Dfinitski/Odyssey_3_2015/BPF_ODY3/1_8_BPF.png

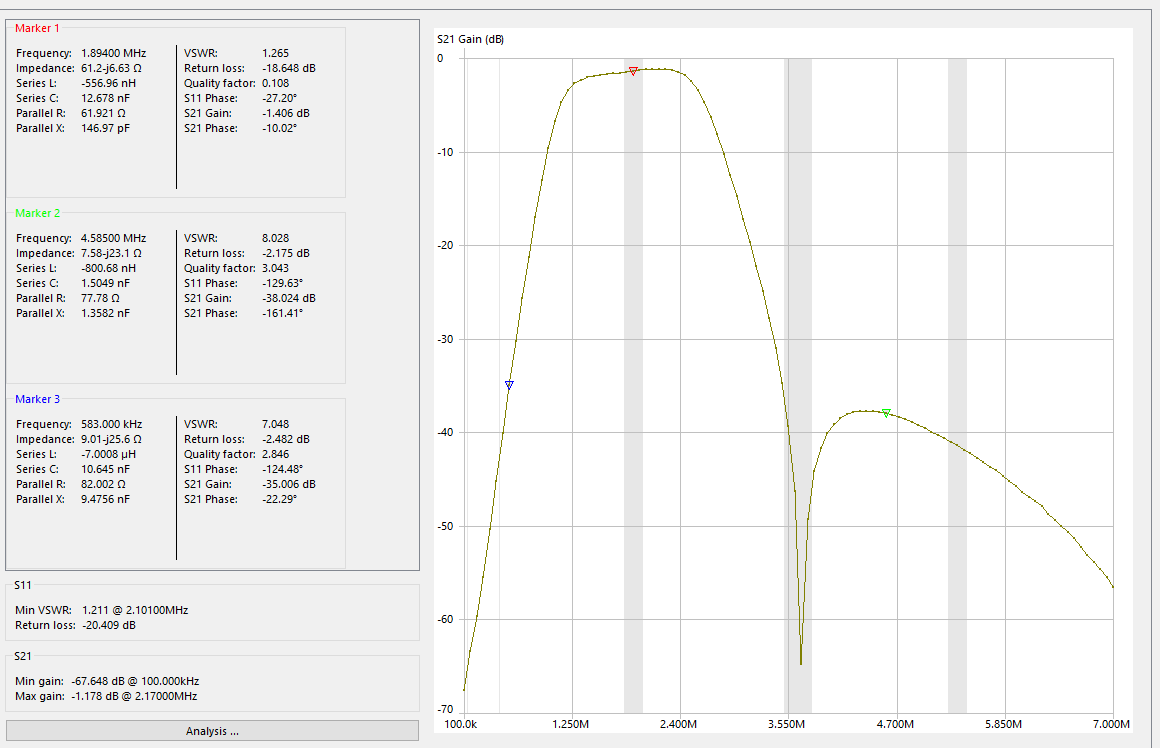
BPF_ODY3/1_8_BPF.png
