Dfinitski/Odyssey_3_2015/BPF_ODY3/3_5_BPF.png

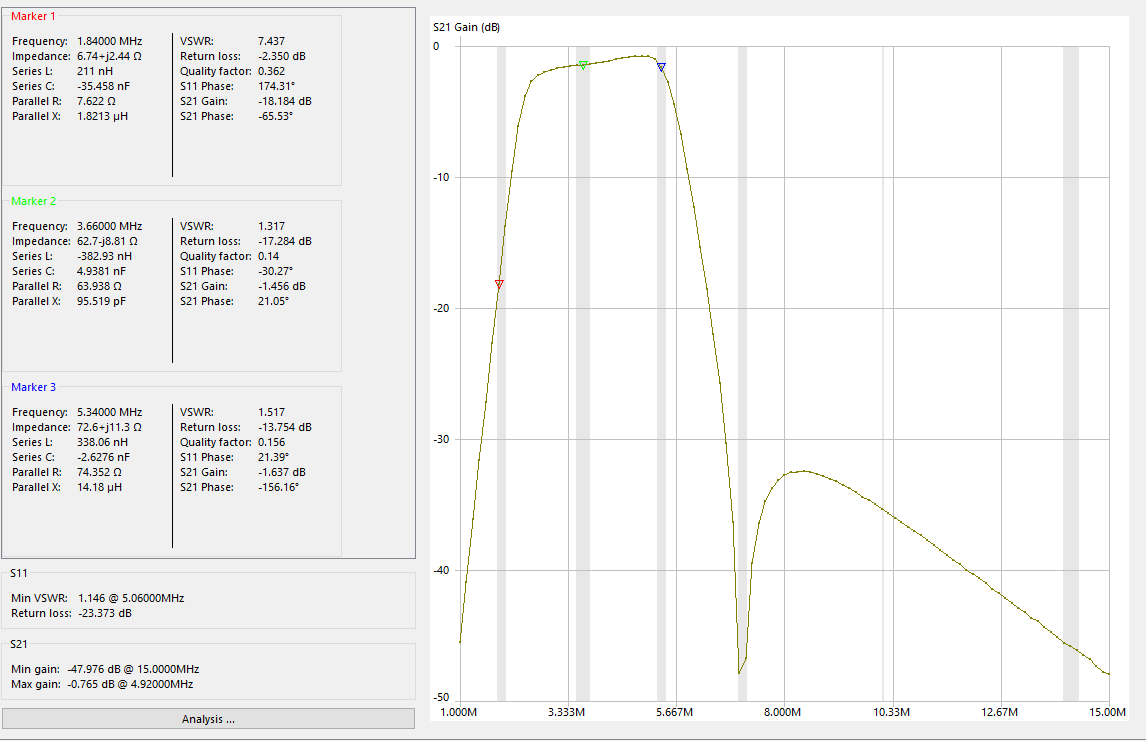
BPF_ODY3/3_5_BPF.png
