Dfinitski/Odyssey_3_2015/BPF_ODY3/7_0_BPF.png

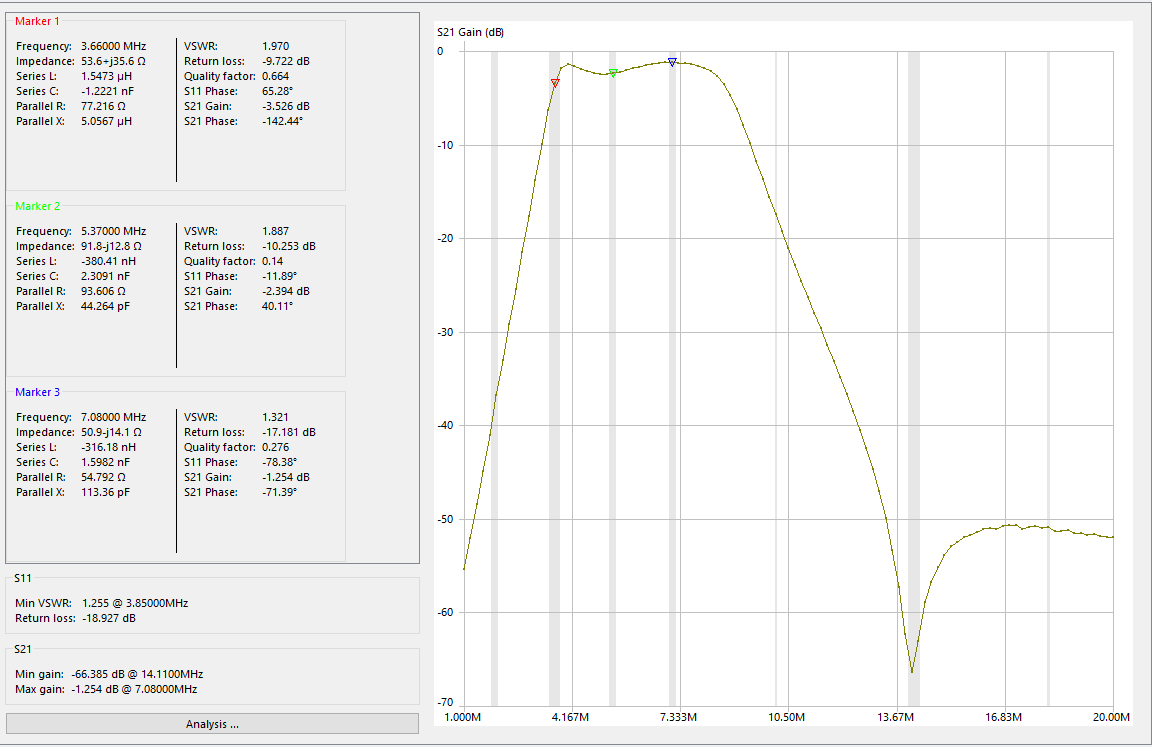
BPF_ODY3/7_0_BPF.png
