Dfinitski/Odyssey_3_2015/BPF_ODY3/14_BPF.png

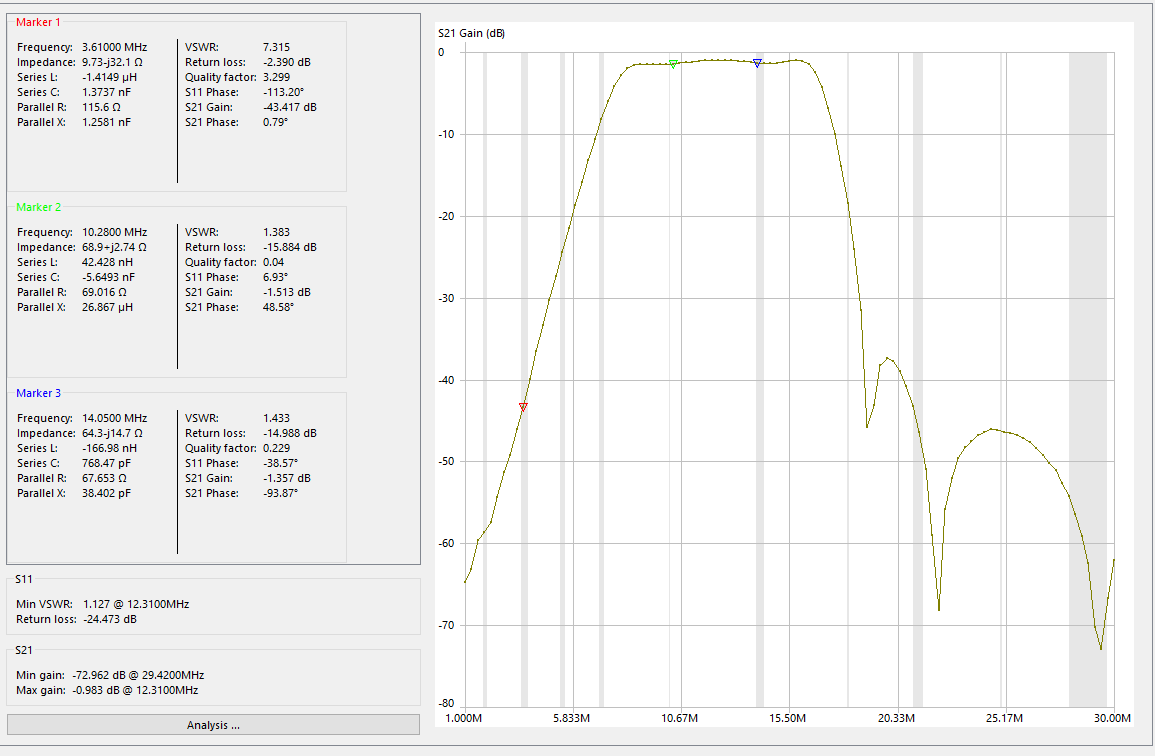
BPF_ODY3/14_BPF.png
