Dfinitski/Odyssey_3_2015/BPF_ODY3/30_BPF.jpg

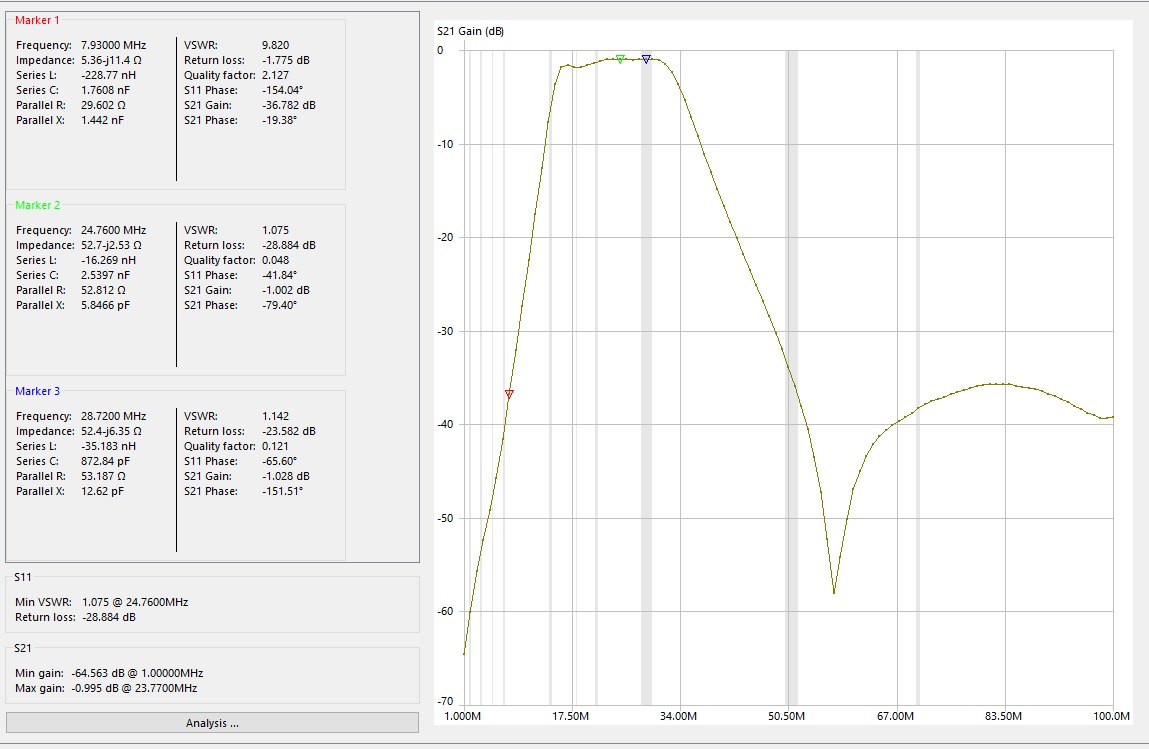
BPF_ODY3/30_BPF.jpg
