Dfinitski/Odyssey_3_2015/BPF_ODY3/50_BPF.png

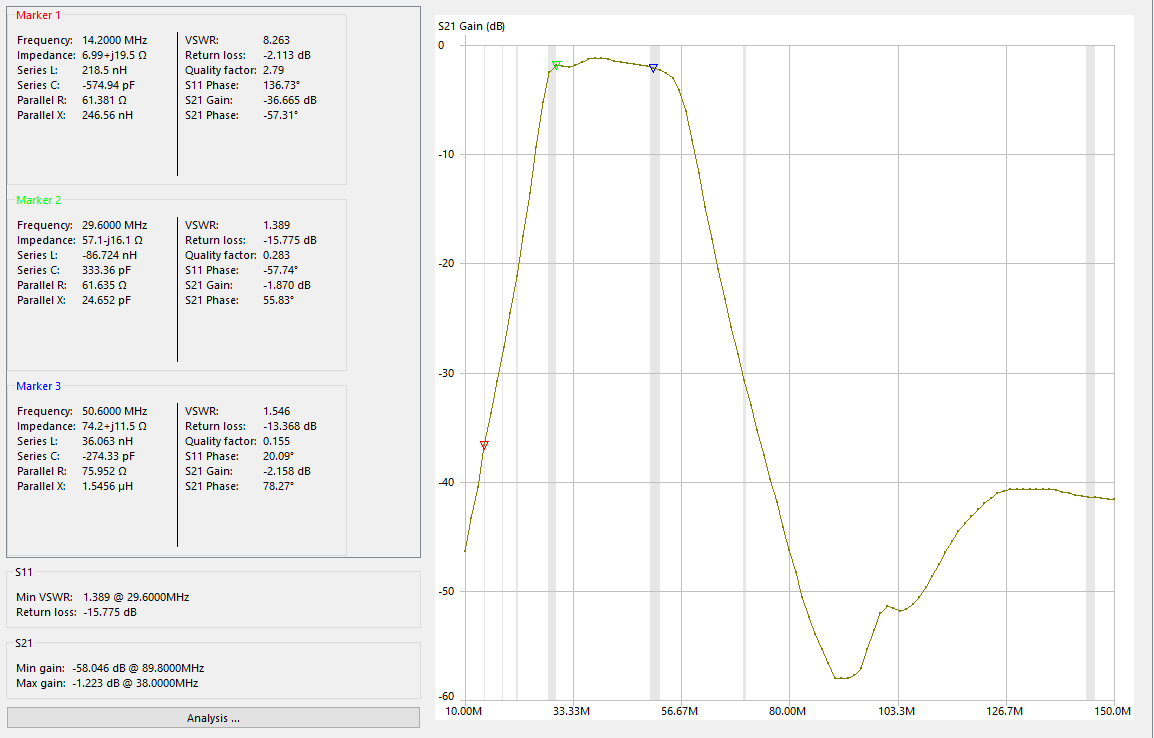
BPF_ODY3/50_BPF.png
