Dfinitski/Odyssey_3_2015/Images/odyssey_on_desk.jpg

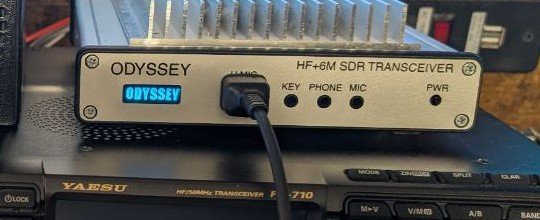
Images/odyssey_on_desk.jpg
