Dfinitski/Odyssey_3_2015/Images/rear_angle.jpg

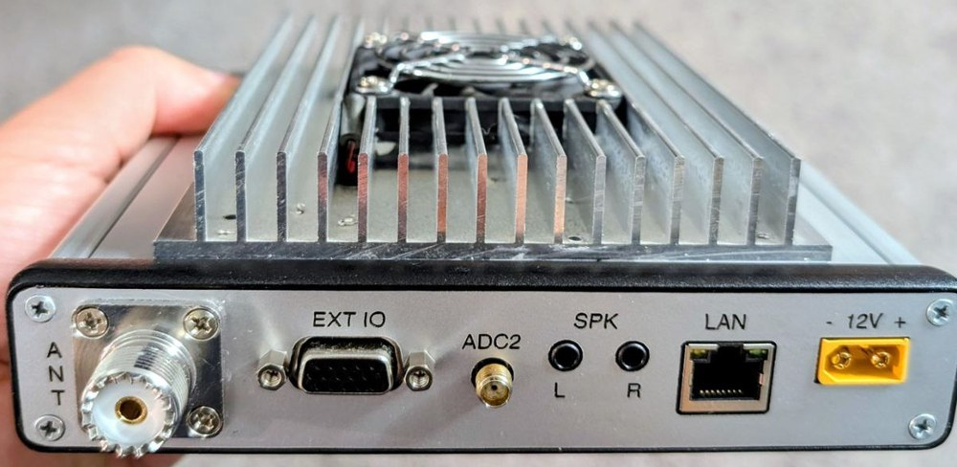
Images/rear_angle.jpg
