Dfinitski/Odyssey_3_2015/Images/station_2.jpg

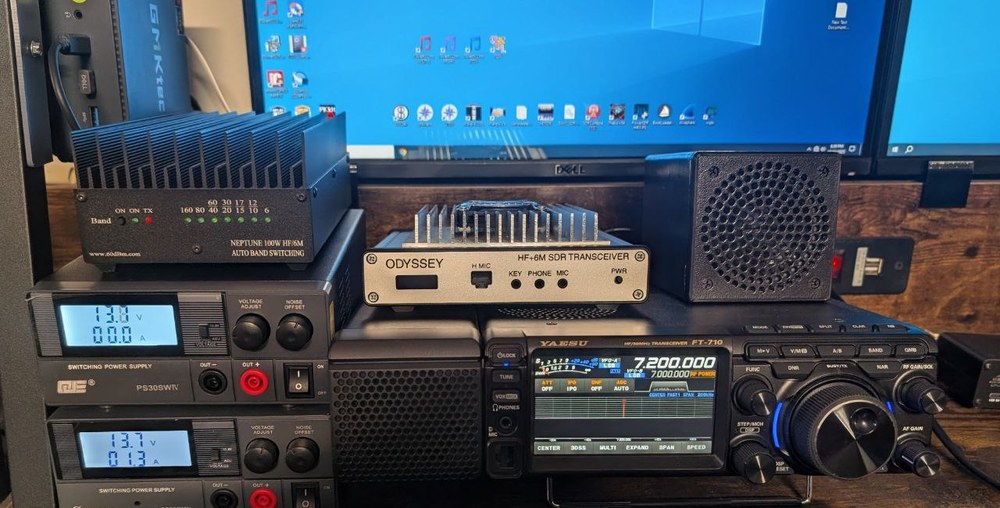
Images/station_2.jpg
