Dfinitski/Odyssey_3_2015/LPF_ODY_3/1_8_LPF.png

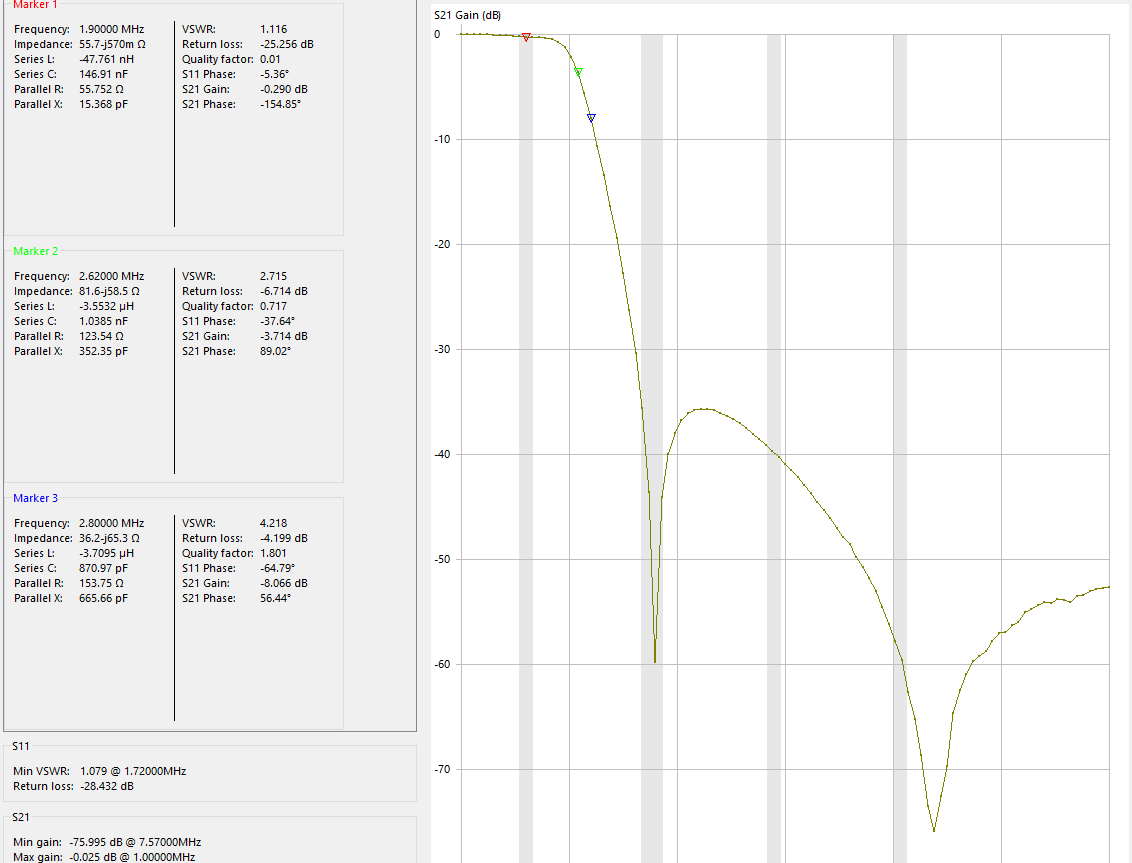
LPF_ODY_3/1_8_LPF.png
