Dfinitski/Odyssey_3_2015/LPF_ODY_3/50_LPF.png

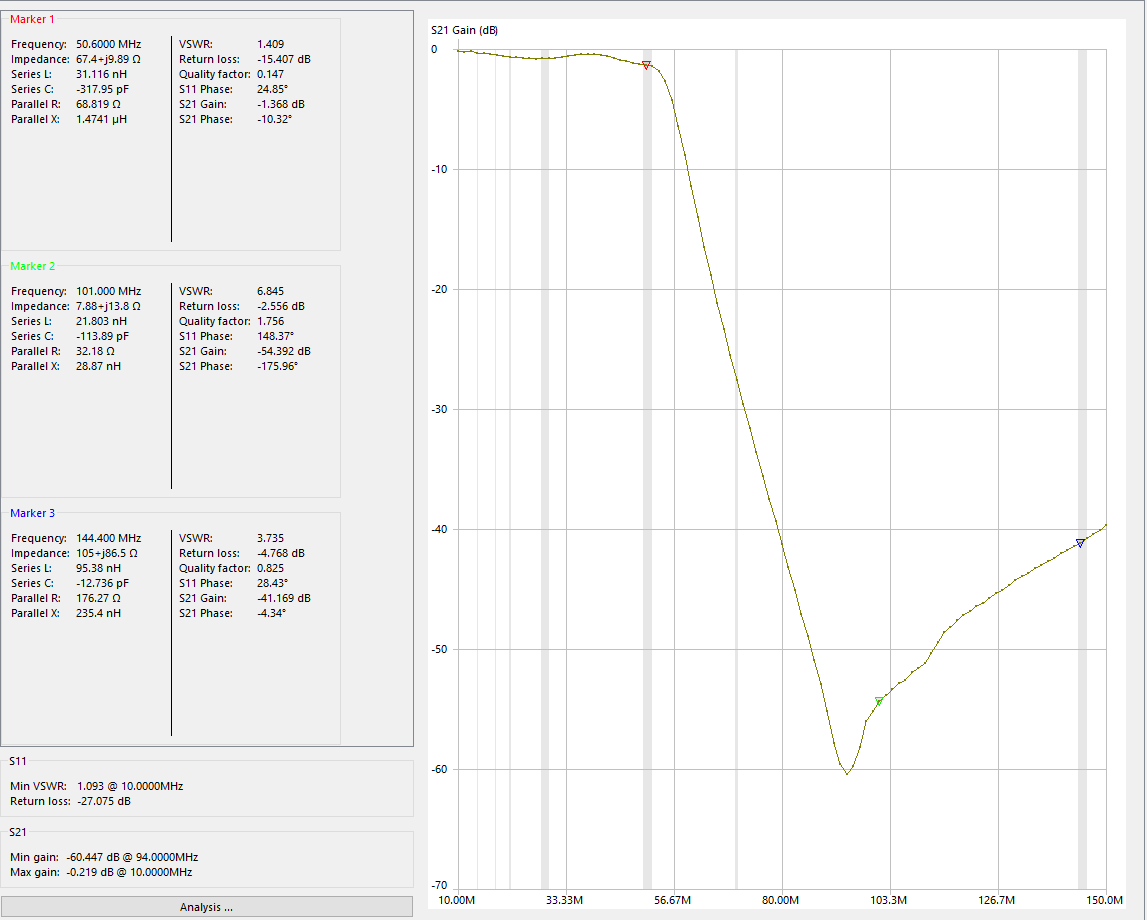
LPF_ODY_3/50_LPF.png
