Dfinitski/Odyssey_3_2015/Metalwork/Copper_Plate.jpg

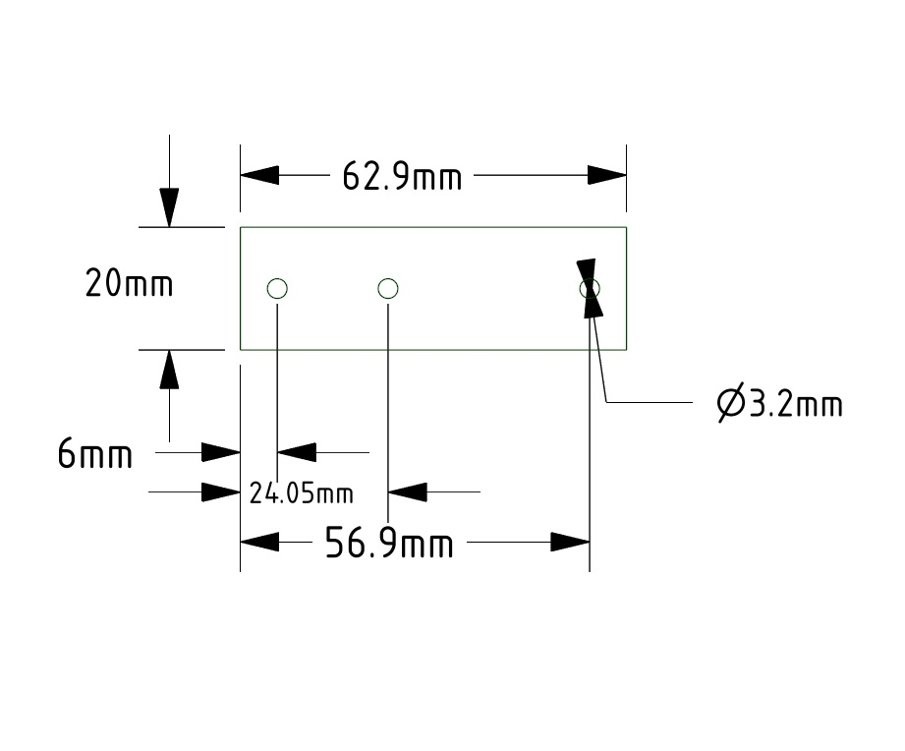
Metalwork/Copper_Plate.jpg
