Dfinitski/Odyssey_3_2015/Metalwork/Heatsink.jpg

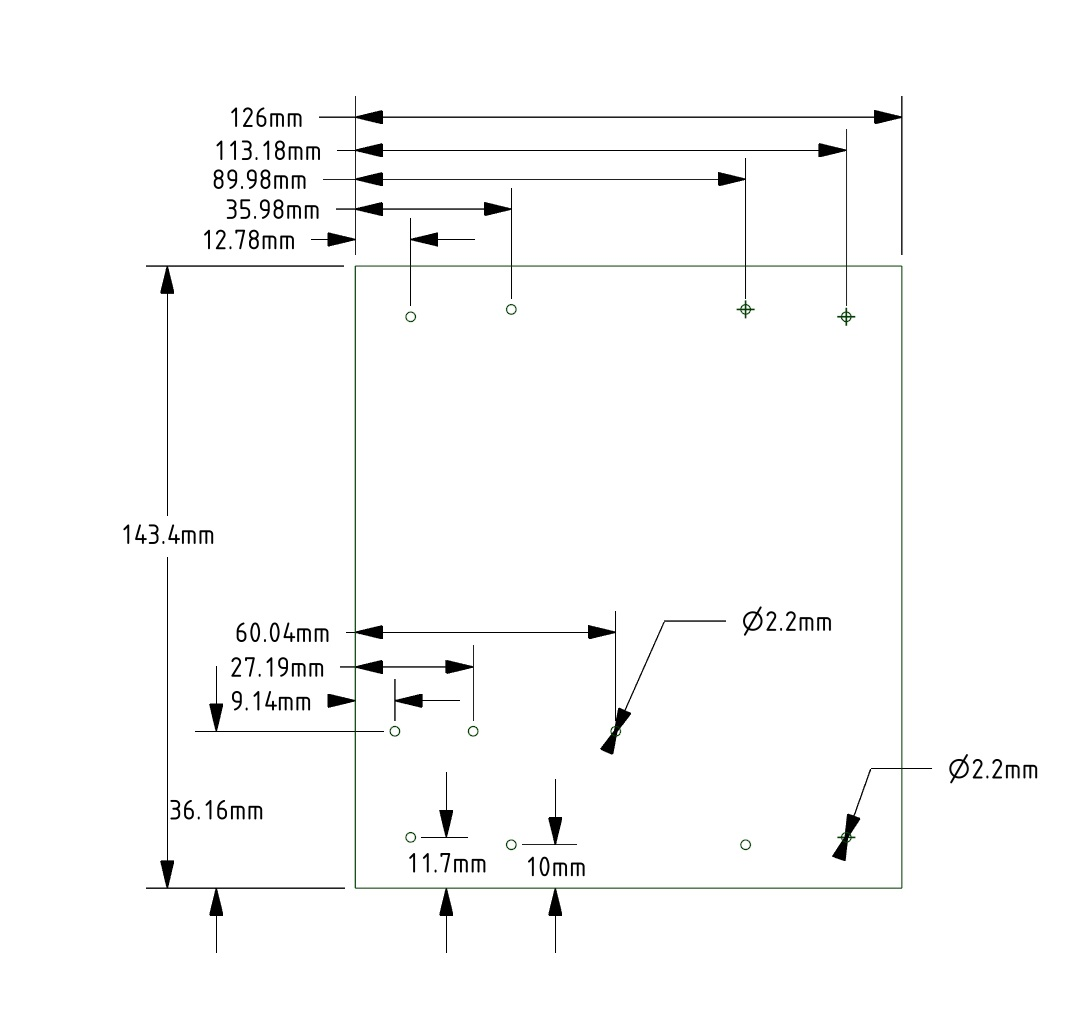
Metalwork/Heatsink.jpg
