Dfinitski/Odyssey_3_2015/Metalwork/Top_Cover.jpg

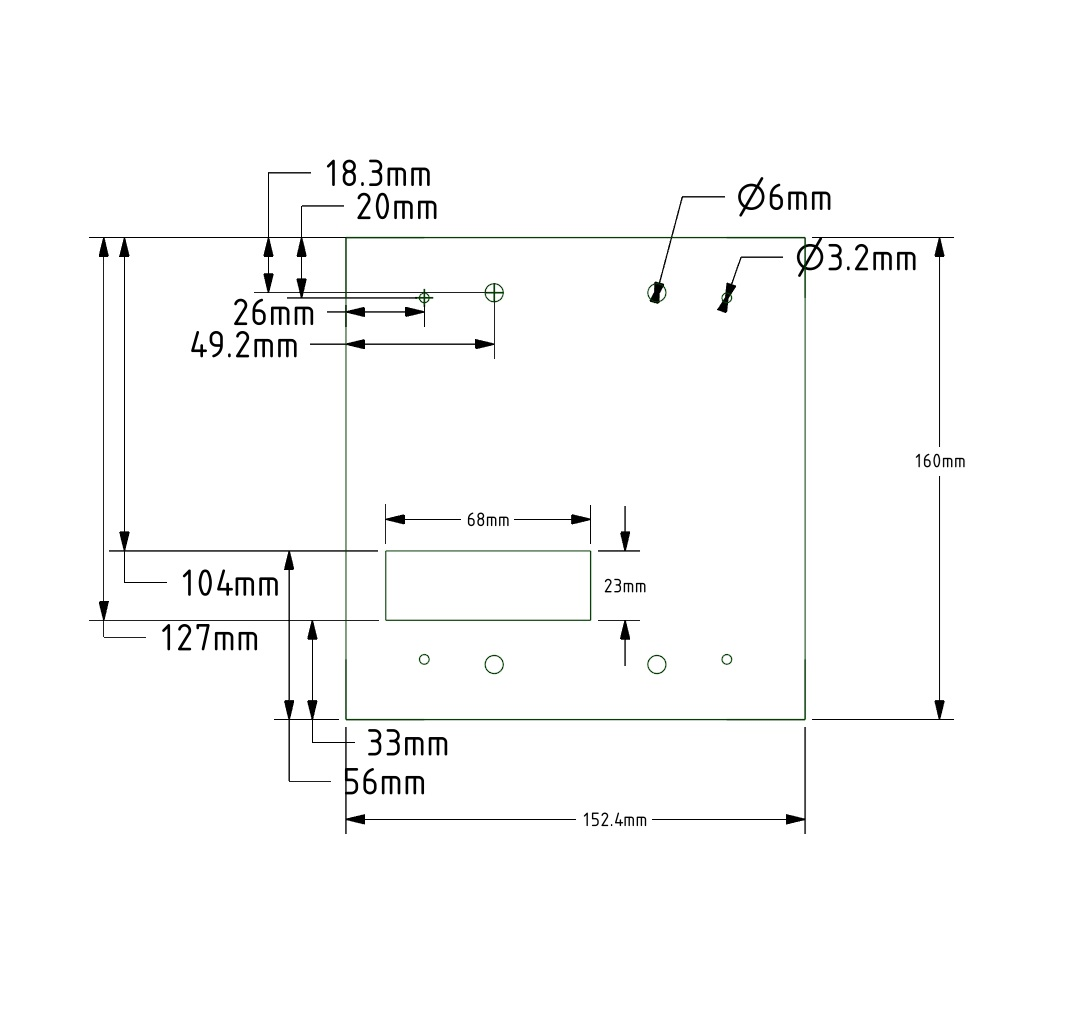
Metalwork/Top_Cover.jpg
