Dfinitski/Odyssey_3_2015/Metalwork/Fan.dxf

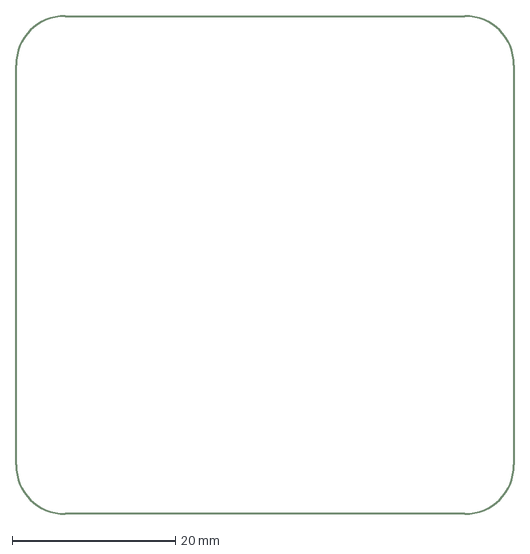
[picture p33: CAD file, 2026-03-22]
Metalwork/Fan.dxf
61.0 x 61.0 mm
