Dfinitski/Odyssey_3_2015/Metalwork/Ody3_Top_Cover.dxf

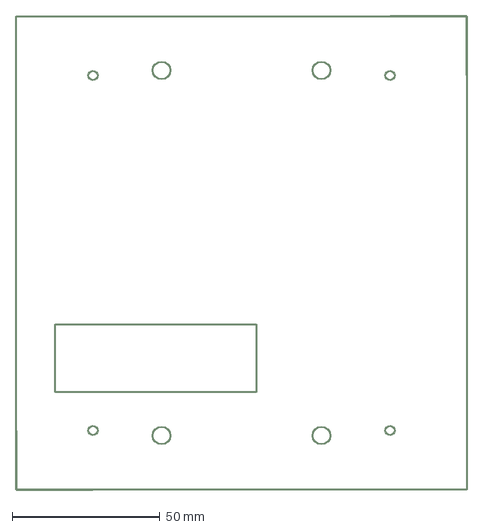
[picture p34: CAD file, 2026-03-16]
Metalwork/Ody3_Top_Cover.dxf
152.4 x 160.0 mm
