Dfinitski/Odyssey_3_2015/Metalwork/Ody3_Copper_Plate.dxf

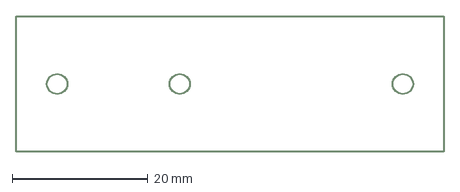
[picture p35: CAD file, 2026-03-16]
Metalwork/Ody3_Copper_Plate.dxf
62.9 x 20.0 mm
