Dfinitski/Odyssey_3_2015/Metalwork/Ody3_Heatseank.dxf

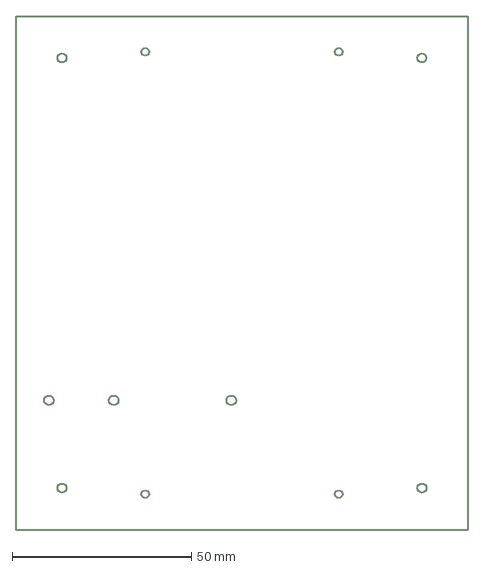
[picture p36: CAD file, 2026-03-16]
Metalwork/Ody3_Heatseank.dxf
126.0 x 143.4 mm
