Dfinitski/Odyssey_3_2015/Metalwork/Front_Panel.dxf

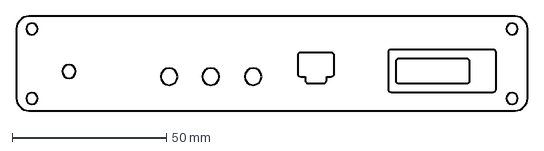
[picture p37: CAD file, 2025-11-01]
Metalwork/Front_Panel.dxf
165.5 x 30.5 mm
