Dfinitski/Odyssey_3_2015/Metalwork/Rear_Panel.dxf

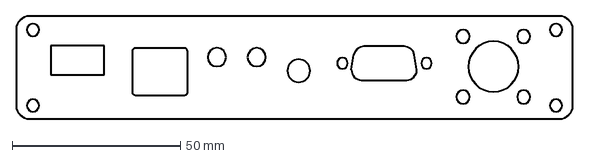
[picture p38: CAD file, 2025-11-01]
Metalwork/Rear_Panel.dxf
165.5 x 30.5 mm
