Dfinitski/Odyssey_3_2015/(list of files, drawings)

Other design files:
PCB/Odyssey_3.lay6
PCB/Odyssey_3_1_8 _C.lay6
PCB/Odyssey_3_1_8.lay6
PCB/Odyssey_3_2_0 .lay6
