Dfinitski/Odyssey_3_2015/Odyssey_3_2.0_ANP/Sources/Odyssey.v

/***********************************************************
*
*	Hermes - new Protocol 
*
************************************************************/

/*
//
//  HPSDR - High Performance Software Defined Radio
//
//  Hermes code. 
//
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
// (C) Phil Harman VK6APH/VK6PH, Kirk Weedman KD7IRS  2006, 2007, 2008, 2009, 2010, 2011, 2012, 2013, 2014, 2015 


       David Fainitski N7DDC, 2025
		 Project Odyssey-III
		 based on Hermes 10.x firmfare

*/

module Odyssey(
	//clock PLL
  input _122MHz_in,              //122.88MHz from DAC
  output _122MHz_out,            // 122.88MHz to DAC
  input  OSC_10MHZ,              //10MHz reference in 
  output FPGA_PLL,               //122.88MHz VCXO contol voltage

  //attenuator (DAT-31-SP+)
  output ATTN_DATA,              //data for input attenuator
  output ATTN_CLK,               //clock for input attenuator
  output ATTN_LE,                //Latch enable for input attenuator
  output ATTN_LE_2,  

  //rx adc 
  input  [15:0]INA,              //samples from ADC_1
  input  [15:0]INA_2,
  input  INA_CLK,                //122.88MHz from ADC_1
  input  INA_CLK_2,
  input  OVERFLOW,               //high indicates ADC has overflow
  input  OVERFLOW_2,

  //tx adc (AD9744ARU)
  output reg  DAC_ALC,           //sets Tx DAC output level
  output reg signed [13:0]DACD,  //Tx DAC data bus
  
  //audio codec (TLV320AIC23B)
  output CBCLK,               
  output CLRCIN, 
  output CLRCOUT,
  output CDIN,                   
  output CMCLK,                  //Master Clock to TLV320 
  output CMODE,                  //sets TLV320 mode - I2C or SPI
  output CCS_N,                    //chip select on TLV320
  output CMOSI,                   //SPI data for TLV320
  output CSCK,                   //SPI clock for TLV320
  input  CDOUT,                  //Mic data from TLV320  
  
  //phy rgmii (KSZ9021RL)
  output [3:0]PHY_TX,
  output PHY_TX_EN,              //PHY Tx enable
  output PHY_TX_CLOCK,           //PHY Tx data clock
  input  [3:0]PHY_RX,     
  input  PHY_RX_DV,                 //PHY has data flag
  input  PHY_RX_CLOCK,           //PHY Rx data clock
  input  PHY_CLK125,             //125MHz clock from PHY PLL
  output PHY_RESET_N, 
  
  //phy mdio (KSZ9021RL)
  inout  PHY_MDIO,               //data line to PHY MDIO
  output PHY_MDC,                //2.5MHz clock to PHY MDIO
	
  // FPGA reload 
  output NCONFIG,                //when high causes FPGA to reload 
  

  
  //misc. i/o
  input  PTT_in,                    //main PTT input, active low
  input  KEY_DOT,                //dot input 
  input  KEY_DASH,               //dash input
  
  output [2:0]BAND,
  output LNA,
  input PTT_in_UO,
  output PTT_out,
  output PTT_out_mcu,
  
  
  
  //user outputs
  output TUNE,
  output [2:0]ANT,
  output [6:0]UO,
  
  // MCU connection
  input u_rx,
  output u_tx,
  
  //debug led's 
  output led1,
  output led2,
  output led3,
  output led4,
  output test1,
  output test2 
 
);







parameter [55:0] fw_version = "2.0 ANP";

assign _122MHz_out = C122_clk;

wire RAND;            			//high turns random on
wire DITH;            			//high turns dither on 


assign UO[0] = run ? Open_Collector[1] : 1'd0;					
assign UO[1] = run ? Open_Collector[2] : 1'd0;   				
assign UO[2] = run ? Open_Collector[3] : 1'd0;  					
assign UO[3] = run ? Open_Collector[4] : 1'd0;  		
assign UO[4] = run ? Open_Collector[5] : 1'd0; 
assign UO[5] = run ? Open_Collector[6] : 1'd0; 
assign UO[6] = run ? Open_Collector[7] : 1'd0; 

assign LNA    = run & !PTT_out ? Open_Collector[7] || Alex_data[3] : 1'd0;
assign ANT[0] = run ? Alex_data[24] : 1'd0;
assign ANT[1] = run ? Alex_data[25] : 1'd0;
assign ANT[2] = run ? Alex_data[26] : 1'd0;

//assign test1 = clock_12_5MHz;
assign PTT_out_mcu = PTT_out;

assign NCONFIG = 0;

localparam NR = 4; 							// number of receivers to implement
localparam master_clock = 122880000; 	// DSP  master clock in Hz.

parameter M_TPD   = 4;
parameter IF_TPD  = 2;

localparam board_type = 8'h03;		  	// 00 for Metis, 01 for Hermes, 02 for ANAN-10E, 03 for Angelia, and 05 for Orion
parameter  Angelia_version = 8'd116;	// FPGA code version
parameter  protocol_version = 8'd33;	// openHPSDR protocol version implemented


//---------------------------------------------------------
//		CLOCKS
//---------------------------------------------------------

wire CLRCLK;
assign CLRCIN  = CLRCLK;
assign CLRCOUT = CLRCLK;


// Generate CMCLK (12.288MHz), CBCLK(3.072MHz) and CLRCLK (48kHz) from 122.88MHz using PLL
// NOTE: CBCLK is generated at 180 degress so that LRCLK occurs on negative edge of BCLK 
PLL_IF PLL_IF_inst (.inclk0(_122MHz_in), .c0(CMCLK), .c1(CBCLK), .c2(CLRCLK));


wire C122_clk;
wire ref_80khz; 
wire osc_80khz;
wire locked_10MHz;

// Use a PLL to divide 10MHz clock to 80kHz
C10_PLL PLL2_inst (.inclk0(OSC_10MHZ), .c0(ref_80khz), .locked(locked_10MHz));

wire locked_80khz;
// Use a PLL to divide 122.88MHz clock to 80kHz							
C122_PLL PLL_inst (.inclk0(INA_CLK), .c0(C122_clk), .c1(osc_80khz), .locked(locked_80khz));	
	
//Apply to EXOR phase detector 
assign FPGA_PLL = ref_80khz ^ osc_80khz; 


//------------------------------------------------------------
//  Reset and initialisation
//------------------------------------------------------------
 
assign PHY_RESET_N = init_done;

// IF reset line
wire  IF_rst;
wire C122_rst;
assign IF_rst = network_state;  // hold IF_clk code in reset 

cdc_sync #(1)
	reset_C122 (.siga(IF_rst), .rstb(0), .clkb(C122_clk), .sigb(C122_rst)); // 122.88MHz clock domain reset
	
// Deadman timer - clears run if no C&C commands received for ~2 seconds.
wire timer_reset = (HW_reset1 | HW_reset2 | HW_reset3 | HW_reset4);

reg [27:0] sec_count;
wire HW_timeout;
always @ (posedge rx_clock)
begin
	if (HW_timer_enable) 
	begin 
		if (timer_reset) sec_count <= 0;
		else if (sec_count != 28'd250_000_000) 	// approx 2 secs. 
		sec_count <= sec_count + 28'd1;
	end 
	else sec_count <= 28'd0;
end

assign HW_timeout = (sec_count >= 28'd250_000_000);

//----------------------------------------------------------------------------------
// Read/Write the  PHY MDIO registers (NOTE: Max clock frequency is 2.5MHz)
//---------------------------------------------------------------------------------- 

// 2026: configuration really runs now (conf_req was tied to 0): 100 ms after
// RESET_N, PHY address auto-detect (fallback 3), 16 ms FLP timing, pad skews,
// 1000BASE-T FD only, restart auto-negotiation.
wire phy_cfg_done, phy_found;
wire [4:0] phy_addr;
phy_cfg phy_config(.clock(osc_80khz), .run(init_done), .mdio_pin(PHY_MDIO), .mdc_pin(PHY_MDC),
                   .done(phy_cfg_done), .found(phy_found), .phy_addr(phy_addr));

// 2026: CLK125_NDO starts only after the PHY leaves reset -> keep the TX PLL
// in reset until 10 ms after RESET_N went high.
reg [9:0] tx_pll_rst_cnt = 10'd0;
reg       tx_pll_areset = 1'b1;
always @(posedge osc_80khz)
  if (!init_done)                     begin tx_pll_rst_cnt <= 10'd0; tx_pll_areset <= 1'b1; end
  else if (tx_pll_rst_cnt != 10'd800) begin tx_pll_rst_cnt <= tx_pll_rst_cnt + 1'd1; tx_pll_areset <= 1'b1; end
  else                                     tx_pll_areset <= 1'b0;
wire tx_pll_locked;

//---------------------------------------------------------------------------------
// Connection to MCU
//---------------------------------------------------------------------------------	
wire [31:0] static_ip;
wire [47:0] local_mac; 	
wire init_done;
wire [11:0] AIN1;  // FWD_power
wire [11:0] AIN2;  // REV_power
wire [11:0] AIN3, AIN4, AIN5, AIN6;  
assign AIN3 = 12'd0;  // User 1
assign AIN4 = 12'd0;  // User 2
assign AIN5 = 12'd2048;
assign AIN6 = 12'd1950;  // holds 12 bit ADC of 13.8v measurement 


//assign led4 = led  & (dim_cnt <= dimmer); 
//wire led;


				
pic_control #(fw_version) pic_cntrl (.run(locked_80khz), .clock(osc_80khz), .u_rx(u_rx), .u_tx(u_tx), .IP(static_ip), .MAC(local_mac),
                                      .init_done(init_done), ._random_bit(INA[0]), .AIN1(AIN1), .AIN2(AIN2)  );

	
	
//-----------------------------------------------------------------------------
// Band Decoder
//-----------------------------------------------------------------------------
wire [31:0]Rx0_frequency = Rx_frequency[0];

Band_decoder b_dec(rx_clock, run , PTT_out, Rx0_frequency[30:16], Tx0_frequency[30:16], BAND);
	
//-----------------------------------------------------------------------------
//                           network module
//-----------------------------------------------------------------------------
wire network_state;
wire [7:0] network_status;
wire rx_clock;
wire tx_clock;
wire udp_rx_active;
wire [7:0] udp_rx_data;
wire udp_tx_active;
wire broadcast;
wire [15:0] udp_tx_length;
wire [7:0] udp_tx_data;
wire udp_tx_request;
wire udp_tx_enable;	
wire dhcp_timeout;
wire dhcp_success;
wire dhcp_failed;
wire icmp_rx_enable;
//wire icmp_rx_enable;
	
network network_inst (

	// inputs	
  .udp_tx_request(udp_tx_request),
  .udp_tx_data(udp_tx_data),  
  .port_ID(port_ID), 
  
  // outputs
  .rx_clock(rx_clock),
  .tx_clock(tx_clock),
  .broadcast(broadcast),
  .udp_rx_active(udp_rx_active),
  .udp_rx_data(udp_rx_data),
  .udp_tx_length(udp_tx_length),
  .udp_tx_active(udp_tx_active),
  .local_mac(local_mac),
  .static_ip(static_ip),
  .pll_areset(tx_pll_areset),
  .pll_locked(tx_pll_locked),
  .udp_tx_enable(udp_tx_enable), 
  .to_port(to_port),   					// UDP port the PC is sending to

	// status outputs	
  .network_state(network_state),	
  .network_status(network_status),
  .dhcp_timeout(dhcp_timeout),
  .dhcp_success(dhcp_success),
  .dhcp_failed(dhcp_failed),  

  //make hardware pins available inside this module
  .PHY_TX(PHY_TX),
  .PHY_TX_EN(PHY_TX_EN),            
  .PHY_TX_CLOCK(PHY_TX_CLOCK),         
  .PHY_RX(PHY_RX),     
  .PHY_DV(PHY_RX_DV),    					// use PHY_DV to be consistent with Metis            
  .PHY_RX_CLOCK(PHY_RX_CLOCK),         
  .PHY_CLK125(PHY_CLK125),
  
  .test1(test1),
  .test2(test2)
  
  );


//-----------------------------------------------------------------------------
//                          sdr receive
//-----------------------------------------------------------------------------
wire sending_sync;
wire discovery_reply;
wire [15:0]to_port;
wire discovery_ACK;
wire discovery_ACK_sync;


sdr_receive sdr_receive_inst(
	//inputs 
	.rx_clock(rx_clock),
	.udp_rx_data(udp_rx_data),
	.udp_rx_active(udp_rx_active),
	.sending_sync(sending_sync),
	.broadcast(broadcast),
	.local_mac(local_mac),
	.to_port(to_port),
	.discovery_ACK(discovery_ACK_sync),	// set when discovery reply request received by sdr_send
	
	//outputs
	.discovery_reply(discovery_reply)
	);
		

//-----------------------------------------------------------------------------
//                               sdr rx, tx & IF clock domain transfers
//-----------------------------------------------------------------------------
wire run_sync;
wire wideband_sync;
wire discovery_reply_sync;

// transfer tx clock domain signals to rx clock domain
sync sync_inst1(.clock(rx_clock), .sig_in(udp_tx_active), .sig_out(sending_sync));   
sync sync_inst2(.clock(rx_clock), .sig_in(discovery_ACK), .sig_out(discovery_ACK_sync));

// transfer rx clock domain signals to tx clock domain  
sync sync_inst5(.clock(tx_clock), .sig_in(discovery_reply), .sig_out(discovery_reply_sync)); 
sync sync_inst6(.clock(tx_clock), .sig_in(run), .sig_out(run_sync)); 
sync sync_inst7(.clock(tx_clock), .sig_in(wideband), .sig_out(wideband_sync));


//-----------------------------------------------------------------------------
//                          sdr send
//-----------------------------------------------------------------------------

wire [7:0] port_ID;
wire [7:0]Mic_data;
wire mic_fifo_rdreq;
wire [7:0]Rx_data[0:NR-1];
wire fifo_ready[0:NR-1];
wire fifo_rdreq[0:NR-1];

sdr_send #(board_type, NR, master_clock, protocol_version) sdr_send_inst(
	//inputs
	.tx_clock(tx_clock),
	.udp_tx_active(udp_tx_active),
	.discovery(discovery_reply_sync),
	.run(run_sync),
	.wideband(wideband_sync),
	.sp_data_ready(sp_data_ready),
	.sp_fifo_rddata(sp_fifo_rddata),		// **** why the odd name - use spectrum_data ?
	.local_mac(local_mac),
	.code_version(Angelia_version),
	.Rx_data(Rx_data),						// Rx I&Q data to send to PHY
	.udp_tx_enable(udp_tx_enable),
	.Mic_data(Mic_data),						// mic data to send to PHY
	.fifo_ready(fifo_ready),				// data available in Rx fifo
	.mic_fifo_ready(mic_fifo_ready),		// data avaiable in mic fifo
	.CC_data_ready(CC_data_ready),      // C&C data availble 
	.CC_data(CC_data),
	.samples_per_frame(samples_per_frame),
	.tx_length(tx_length),
	.Wideband_packets_per_frame(Wideband_packets_per_frame),  
	.checksum(),  
	
	//outputs
	.udp_tx_data(udp_tx_data),
	.udp_tx_length(udp_tx_length),
	.udp_tx_request(udp_tx_request),
	.fifo_rdreq(fifo_rdreq),				// high to indicate read from Rx fifo required
	.sp_fifo_rdreq	(sp_fifo_rdreq	),		// high to indicate read from spectrum fifo required
	.port_ID(port_ID),
	.mic_fifo_rdreq(mic_fifo_rdreq),		// high to indicate read from mic fifo required
	.CC_ack(CC_ack),							// ack to CC_encoder that send request received
	.WB_ack(WB_ack),							// ack to WB controller that send request received	
	.phy_ready(phy_ready),					// set when PHY is not sending DDC data
	.discovery_ACK(discovery_ACK) 		// set to acknowlege discovery reply received
	 ); 		
 		

//---------------------------------------------------------
// 		Set up TLV320 using SPI 
//---------------------------------------------------------
TLV320_SPI TLV (.clk(CMCLK), .CMODE(CMODE), .nCS(CCS_N), .MOSI(CMOSI), .SSCK(CSCK), .boost(Mic_boost), .line(Line_In), .line_in_gain(Line_In_Gain));

//-------------------------------------------------------------------------
//			Determine number of I&Q samples per frame when in Sync or Mux mode
//-------------------------------------------------------------------------

reg [15:0] samples_per_frame[0:NR-1] ;
reg [15:0] tx_length[0:NR-1];				// calculate length of Tx packet here rather than do it at high speed in the Ethernet code. 

generate
genvar j;

for (j = 0 ; j < NR; j++)
	begin:q

		always @ (*)
		begin 
			samples_per_frame[j] <= 16'd238;
			tx_length[j] <= 16'd1444;
	   end 
	end

endgenerate

//------------------------------------------------------------------------
//   Rx(n)_fifo  (2k Bytes) Dual clock FIFO - Altera Megafunction (dcfifo)
//------------------------------------------------------------------------

/*
	  
						   +-------------------+
     Rx(n)_fifo_data	|data[7:0]		wrful| Rx(n)_fifo_full
						   |				        |
	  Rx(n)_fifo_wreq	|wreq		           | 
						   |					     |
		     C122_clk	|>wrclk	wrused[9:0]| 
						   +-------------------+
     fifo_rdreq[n]	|rdreq		  q[7:0]| Rx_data[n]
						   |					     |
	     tx_clock		|>rdclk		rdempty | Rx_fifo_empty[n]
		               |                   |
						   |		 rdusedw[11:0]| Rx(n)_used*  (0 to 2047 bytes)
						   +-------------------+
						   |                   |
   Rx_fifo_clr[n] OR |aclr               |
	 IF_rst	OR !run	+-------------------+
	 OR fifo_clear
		
 * added extra bit so that does not read empty when full.    

*/

wire 			Rx_fifo_wreq[0:NR-1];
wire  [7:0] Rx_fifo_data[0:NR-1];
wire        Rx_fifo_full[0:NR-1];
wire [11:0] Rx_used[0:NR-1];
wire        Rx_fifo_clr[0:NR-1];
wire 			Rx_fifo_empty;
wire 			fifo_clear;
wire 			fifo_clear1;
wire 			write_enable;
wire 			phy_ready;
wire 			convert_state;
wire 			C122_run;

// This is just for Rx0 since it can sync with Rx1.

		Rx_fifo Rx0_fifo_inst(.wrclk (C122_clk),.rdreq (fifo_rdreq[0]),.rdclk (tx_clock),.wrreq (Rx_fifo_wreq[0] && write_enable), 
							 .data (Rx_fifo_data[0]), .q (Rx_data[0]), .wrfull(Rx_fifo_full[0]), .rdempty(Rx_fifo_empty),
							 .rdusedw(Rx_used[0]), .aclr (IF_rst | Rx_fifo_clr[0] | !run | fifo_clear ));  											
							  
		Rx_fifo_ctrl0 #(NR) Rx0_fifo_ctrl_inst( .reset(!C122_run || !C122_EnableRx0_7[0] ), .clock(C122_clk), .data_in_I(rx_I[1]), .data_in_Q(rx_Q[1]), // was rx_Q[1]
							.spd_rdy(strobe[0]), .spd_rdy2(strobe[1]), .fifo_full(Rx_fifo_full[0]), .Rx_fifo_empty(C122_Rx_fifo_empty),  //.Rx_number(d),
							.wrenable(Rx_fifo_wreq[0]), .data_out(Rx_fifo_data[0]), .fifo_clear(Rx_fifo_clr[0]),
							.Sync_data_in_I(rx_I[0]), .Sync_data_in_Q(rx_Q[0]), .Sync(C122_SyncRx[0]), .convert_state(convert_state));	
													
		assign  fifo_ready[0] = (Rx_used[0] > 12'd1427) ? 1'b1 : 1'b0;  // used to signal that fifo has enough data to send to PC
		
// When Mux first set, inhibit fifo write then wait for PHY to be looking for more Rx0 data to ensure there is no data in transit.
// Then reset fifo then wait for 48 to 8 converter to be looking for Rx0 DDC data at first byte. Then enable write to fifo again.


// move flags into correct clock domains
wire C122_phy_ready;
wire C122_Rx_fifo_empty;
cdc_sync #(1) cdc_phyready  (.siga(phy_ready), .rstb(C122_rst), .clkb(C122_clk), .sigb(C122_phy_ready));
cdc_sync #(1) cdc_Rx_fifo_empty  (.siga(Rx_fifo_empty), .rstb(C122_rst), .clkb(C122_clk), .sigb(C122_Rx_fifo_empty));

cdc_sync #(1) C122_run_sync  (.siga(run), .rstb(C122_rst), .clkb(C122_clk), .sigb(C122_run));
cdc_sync #(16) C122_EnableRx0_7_sync  (.siga(EnableRx0_7), .rstb(C122_rst), .clkb(C122_clk), .sigb(C122_EnableRx0_7));

Mux_clear Mux_clear_inst( .clock(C122_clk), .Mux(C122_SyncRx[0][1]), .phy_ready(C122_phy_ready), .convert_state(convert_state), .SampleRate(C122_SampleRate[0]),
								  .fifo_clear(fifo_clear), .fifo_clear1(fifo_clear1), .fifo_write_enable(write_enable), .fifo_empty(C122_Rx_fifo_empty), .reset(!C122_run));	
								  
		Rx_fifo Rx1_fifo_inst(.wrclk (C122_clk),.rdreq (fifo_rdreq[1]),.rdclk (tx_clock),.wrreq (Rx_fifo_wreq[1]), 
							 .data (Rx_fifo_data[1]), .q (Rx_data[1]), .wrfull(Rx_fifo_full[1]),
							 .rdusedw(Rx_used[1]), .aclr (IF_rst | Rx_fifo_clr[1] | !C122_run | fifo_clear1));   // ***** added fifo_clear1

		Rx_fifo_ctrl #(NR) Rx1_fifo_ctrl_inst( .reset(!C122_run || !C122_EnableRx0_7[1]), .clock(C122_clk),   
							.spd_rdy(strobe[1]), .fifo_full(Rx_fifo_full[1]), //.Rx_number(d),
							.wrenable(Rx_fifo_wreq[1]), .data_out(Rx_fifo_data[1]), .fifo_clear(Rx_fifo_clr[1]),
							.Sync_data_in_I(rx_I[1]), .Sync_data_in_Q(rx_Q[1]), .Sync(0));
													
		assign  fifo_ready[1] = (Rx_used[1] > 12'd1427) ? 1'b1 : 1'b0;  // used to signal that fifo has enough data to send to PC

generate
genvar d;

for (d = 2 ; d < NR; d++)
	begin:p

		Rx_fifo Rx_fifo_inst(.wrclk (C122_clk),.rdreq (fifo_rdreq[d]),.rdclk (tx_clock),.wrreq (Rx_fifo_wreq[d]), 
							 .data (Rx_fifo_data[d]), .q (Rx_data[d]), .wrfull(Rx_fifo_full[d]),
							 .rdusedw(Rx_used[d]), .aclr (IF_rst | Rx_fifo_clr[d] | !C122_run));

		// Convert 48 bit Rx I&Q data (24bit I, 24 bit Q) into 8 bits to feed Tx FIFO. Only run if EnableRx0_7[x] is set.
		// If Sync[n] enabled then select the data from the receiver to be synchronised.
		// Do this by using C122_SyncRx(n) to select the required receiver I & Q data.

		Rx_fifo_ctrl #(NR) Rx0_fifo_ctrl_inst( .reset(!C122_run || !C122_EnableRx0_7[d]), .clock(C122_clk),   
							.spd_rdy(strobe[d]), .fifo_full(Rx_fifo_full[d]), //.Rx_number(d),
							.wrenable(Rx_fifo_wreq[d]), .data_out(Rx_fifo_data[d]), .fifo_clear(Rx_fifo_clr[d]),
							.Sync_data_in_I(rx_I[d]), .Sync_data_in_Q(rx_Q[d]), .Sync(0));
													
		assign  fifo_ready[d] = (Rx_used[d] > 12'd1427) ? 1'b1 : 1'b0;  // used to signal that fifo has enough data to send to PC

	end
endgenerate

											  
//------------------------------------------------------------------------
//   Mic_fifo  (1024 words) Dual clock FIFO - Altera Megafunction (dcfifo)
//------------------------------------------------------------------------

/*
						   +-------------------+
         mic_data 	|data[15:0]	  wrfull| 
						   |				        |
		mic_data_ready	|wrreq		        |
						   |					     |
				 CBCLK	|>wrclk	           | 
						   +-------------------+
   mic_fifo_rdreq		|rdreq		  q[7:0]| Mic_data
						   |					     |
	     tx_clock		|>rdclk		        | 
						   |		 rdusedw[11:0]| mic_rdused* (0 to 2047 bytes)
						   +-------------------+
			            |                   |
	         !run  	|aclr               |
				         +-------------------+
							
		* additional bit added so not zero when full.
		LSByte of input data is output first
	
*/

wire [11:0]	mic_rdused; 
							  
Mic_fifo Mic_fifo_inst(.wrclk (CBCLK),.rdreq (mic_fifo_rdreq),.rdclk (tx_clock),.wrreq (mic_data_ready), 
							  .data ({mic_data[7:0], mic_data[15:8]}), .q (Mic_data), .wrfull(),
                       .rdusedw(mic_rdused), .aclr(!run)); 

wire mic_fifo_ready = mic_rdused > 12'd131 ? 1'b1 : 1'b0;		// used to indicate that fifo has enough data to send to PC.					  
							  
//----------------------------------------------
//		Get mic data from  TLV320 in I2S format 
//---------------------------------------------- 

wire [15:0] mic_data;
wire mic_data_ready;

mic_I2S mic_I2S_inst (.clock(CBCLK), .CLRCLK(CLRCLK), .in(CDOUT), .mic_data(mic_data), .ready(mic_data_ready));

	 
//------------------------------------------------
//   SP_fifo  (16k words) dual clock FIFO
//------------------------------------------------

/*
        The spectrum data FIFO is 16 by 2k words long on the input.
        Output is in Bytes for easy interface to the PHY code
        NB: The output flags are only valid after a read/write clock has taken place

       
							   SP_fifo
						+--------------------+
  Wideband_source |data[15:0]	   wrfull| sp_fifo_wrfull
						|				         |
	sp_fifo_wrreq	|wrreq	     wrempty| sp_fifo_wrempty
						|				         |
			C122_clk	|>wrclk              | 
						+--------------------+
	sp_fifo_rdreq	|rdreq		   q[7:0]| sp_fifo_rddata
						|                    | 
						|				         |
		 tx_clock	|>rdclk		         | 
						|		               | 
						+--------------------+
						|                    |
	   !wideband   |aclr                |
		      	   |                    |
	    				+--------------------+
		
*/

wire  sp_fifo_rdreq;
wire [7:0]sp_fifo_rddata;
wire sp_fifo_wrempty;
wire sp_fifo_wrfull;
wire sp_fifo_wrreq;


//-----------------------------------------------------------------------------
//   Wideband Spectrum Data 
//-----------------------------------------------------------------------------

//	When sp_fifo_wrempty fill fifo with 'user selected' # words of consecutive ADC samples.
// Pass sp_data_ready to sdr_send to indicate that data is available.
// Reset fifo when !wideband so the data always starts at a known state.
// The time between fifo fills is set by the user (0-255mS). . The number of  samples sent per UDP frame is set by the user
// (default to 1024) as is the sample size (defaults to 16 bits).
// The number of frames sent, per fifo fill, is set by the user - currently set at 8 i.e. 4,096 samples. 


wire have_sp_data;

wire wideband = (Wideband_enable[0] | Wideband_enable[1]);  							// enable Wideband data if either selected
wire [15:0] Wideband_source = Wideband_enable[0] ? temp_ADC[0] : temp_ADC[1];	// select Wideband data source ADC0 or ADC1

SP_fifo  SPF (.aclr(!wideband), .wrclk (C122_clk), .rdclk(tx_clock), 
             .wrreq (sp_fifo_wrreq), .data ({Wideband_source[7:0], Wideband_source[15:8]}), .rdreq (sp_fifo_rdreq),
             .q(sp_fifo_rddata), .wrfull(sp_fifo_wrfull), .wrempty(sp_fifo_wrempty)); 	
				 
sp_rcv_ctrl SPC (.clk(C122_clk), .reset(0), .sp_fifo_wrempty(sp_fifo_wrempty),
                 .sp_fifo_wrfull(sp_fifo_wrfull), .write(sp_fifo_wrreq), .have_sp_data(have_sp_data));	
				 
// **** TODO: change number of samples in FIFO (presently 16k) based on user selection **** 


// wire [:0] update_rate = 100T ?  12500 : 125000; // **** TODO: need to change counter target when run at 100T.
wire [17:0] update_rate = 125000;

reg  sp_data_ready;
reg [24:0]wb_counter;
wire WB_ack;

always @ (posedge tx_clock)	
begin
	if (wb_counter == (Wideband_update_rate * update_rate)) begin	  // max delay 255mS
		wb_counter <= 25'd0;
		if (have_sp_data & wideband) sp_data_ready <= 1'b1;	  
	end
	else begin 
			wb_counter <= wb_counter + 25'd1;
			if (WB_ack) sp_data_ready <= 0;  // wait for confirmation that request has been seen
	end
end		


//----------------------------------------------------
//   					Rx_Audio_fifo
//----------------------------------------------------

/*
							  Rx_Audio_fifo (4k) 
							
								+--------------------+
				 audio_data |data[31:0]	  wrfull | Audio_full
								|				         |
	Rx_Audio_fifo_wrreq	|wrreq				   |
								|					      |									    
				 rx_clock	|>wrclk	 		      |
								+--------------------+								
	  get_audio_samples  |rdreq		  q[31:0]| LR_data 
								|					      |					  			
								|   		            | 
								|            rdempty | Audio_empty 							
				    CBCLK	|>rdclk              |    
								+--------------------+								
								|                    |
		  !run OR IF_rst  |aclr                |								
								+--------------------+	
								
	Only request audio samples if fifo not empty 						
*/

wire Rx_Audio_fifo_wrreq;
wire  [31:0] temp_LR_data;
wire  [31:0] LR_data;
wire get_audio_samples;  // request audio samples at 48ksps
wire Audio_full;
wire Audio_empty;
wire get_samples;
wire [31:0]audio_data;
wire Audio_seq_err;
reg [10:0]Rx_Audio_Used;

Rx_Audio_fifo Rx_Audio_fifo_inst(.wrclk (rx_clock),.rdreq (get_audio_samples),.rdclk (CBCLK),.wrreq(Rx_Audio_fifo_wrreq), 
			.rdusedw(Rx_Audio_Used), .data (audio_data),.q (LR_data),	.aclr(IF_rst | !run), .wrfull(Audio_full), .rdempty(Audio_empty));
					 
// Manage Rx Audio data to feed to Audio FIFO  - parameter is port #
byte_to_32bits #(1028) Audio_byte_to_32bits_inst
			(.clock(rx_clock), .run(run), .udp_rx_active(udp_rx_active), .udp_rx_data(udp_rx_data), .to_port(to_port),
			 .fifo_wrreq(Rx_Audio_fifo_wrreq), .data_out(audio_data), .sequence_error(Audio_seq_err), .full(Audio_full));
			
// select sidetone when CW key active and sidetone_level is not zero else Rx audio.
reg [31:0] Rx_audio;
wire [33:0] Mixed_audio;
wire signed [31:0] Mixed_LR;
wire signed [15:0] Mixed_side;
reg [5:0] Mix_count = 6'd0;

// if break_in (QSK) mix in rx audio as well
always @ (posedge CBCLK)    
begin
    Mix_count <= Mix_count + 1'd1;
    case (Mix_count)
        56:
        begin
            Mixed_side <= (prof_sidetone + 16'd32768) >> 1;
            Mixed_LR[31:16] <= (LR_data[31:16] + 16'd32768) >> 1;
            Mixed_LR[15:0] <= (LR_data[15:0] + 16'd32768) >> 1;
        end

        58:
        begin
            Mixed_audio[33:17] <=  (Mixed_LR[31:16] + Mixed_side) - (Mixed_LR[31:16] * Mixed_side / 17'd65536);
            Mixed_audio[16:0] <=  (Mixed_LR[15:0] + Mixed_side) - (Mixed_LR[15:0] * Mixed_side / 17'd65536);
        end

        60:
        begin
            if (Mixed_audio[33:17] == 17'd65536)
                Mixed_audio[33:17] <= 17'd65535;
            if (Mixed_audio[16:0] == 17'd65536)
                Mixed_audio[16:0] <= 17'd65535;
        end

        62:
        begin
            if (CW_PTT && (sidetone_level != 0))
            begin
                if (break_in)
                begin
                    Rx_audio[31:16] <= Mixed_audio[33:17] - 17'd32768;
                    Rx_audio[15:0] <= Mixed_audio[16:0] - 17'd32768;
                end
                else
                    Rx_audio <= {prof_sidetone, prof_sidetone};
            end
            else
                Rx_audio <= LR_data;
        end
    endcase
end

// send receiver audio to TLV320 in I2S format, swap L&R
audio_I2S audio_I2S_inst (.run(run), .empty(Audio_empty), .BCLK(CBCLK), .rdusedw(Rx_Audio_Used), .LRCLK(CLRCLK),
                         .data_in({Rx_audio[15:0], Rx_audio[31:16]}), .data_out(CDIN), .get_data(get_audio_samples)); 


//----------------------------------------------------
//   					Tx1_IQ_fifo
//----------------------------------------------------

/*
							   Tx1_IQ_fifo (4k) 
							
								+--------------------+
			 Tx1_IQ_data   |data[47:0]	         | 
								|				         |
			Tx1_fifo_wrreq |wrreq  wrusedw[11:0]|	write_used[11:0]	
								|					      |									    
				 rx_clock	|>wrclk	 	         | 
								+--------------------+								
	               req1  |rdreq		  q[47:0]| C122_IQ1_data
								|					      |					  			
								|   		            | 
								|                    | 							
				  _122MHz	|>rdclk              | 	    
								+--------------------+								
								|                    |
		  !run | IF_rst   |aclr                |								
								+--------------------+	
								
*/


wire Tx1_fifo_wrreq;
wire [47:0]C122_IQ1_data;
wire [47:0]Tx1_IQ_data;
wire [12:0]write_used;

Tx1_IQ_fifo Tx1_IQ_fifo_inst(.wrclk (rx_clock),.rdreq (req1),.rdclk (C122_clk),.wrreq(Tx1_fifo_wrreq), 
					 .data (Tx1_IQ_data), .q(C122_IQ1_data), .aclr(!run | IF_rst), .wrusedw(write_used));
					 
// Manage Tx I&Q data to feed to Tx  - parameter is port #
byte_to_48bits #(1029) IQ_byte_to_48bits_inst
			(.clock(rx_clock), .run(run), .udp_rx_active(udp_rx_active), .udp_rx_data(udp_rx_data), .to_port(to_port),
			 .fifo_wrreq(Tx1_fifo_wrreq), .data_out(Tx1_IQ_data), .full(1'b0), .sequence_error());					 

// Ensure I&Q data is zero if not trasmitting
wire [47:0] IQ_Tx_data = PTT_out ? C122_IQ1_data : 48'b0; 													

// indicate how full or empty the FIFO is - was required by Simon G4ELI code but no longer required. 
//wire almost_full 	= (write_used > 13'd3584) ? 1'b1 : 1'b0; //(write_used[11:8] == 4'b1111) ? 1'b1 : 1'b0;  // >= 3,840 samples
//wire almost_empty = (write_used < 13'd512)  ? 1'b1 : 1'b0; //(write_used[11:9] == 4'b0001) ? 1'b1 : 1'b0;  // <= 511 samples

				 
//--------------------------------------------------------------------------------------------
//  	Iambic CW Keyer
//--------------------------------------------------------------------------------------------

wire keyout;

// parameter is clock speed in kHz.
iambic #(48) iambic_inst (.clock(CLRCLK), .cw_speed(keyer_speed),  .iambic(iambic), .keyer_mode(keyer_mode), .weight(keyer_weight), 
                          .letter_space(keyer_spacing), .dot_key(!KEY_DOT | Dot), .dash_key(!KEY_DASH | Dash),
								  .CWX(CWX), .paddle_swap(key_reverse), .keyer_out(keyout));
						  
//--------------------------------------------------------------------------------------------
//  	Calculate  Raised Cosine profile for sidetone and CW envelope when internal CW selected 
//--------------------------------------------------------------------------------------------

wire CW_char;
assign CW_char = (keyout & internal_CW & run);		// set if running, internal_CW is enabled and either CW key is active
wire [15:0] CW_RF;
wire [15:0] profile;
wire CW_PTT;

profile profile_sidetone (.clock(CLRCLK), .CW_char(CW_char), .profile(profile),  .delay(8'd0));
profile profile_CW       (.clock(CLRCLK), .CW_char(CW_char), .profile(CW_RF),    .delay(RF_delay), .hang(hang), .PTT(CW_PTT));

//--------------------------------------------------------
//			Generate CW sidetone with raised cosine profile
//--------------------------------------------------------	
wire signed [15:0] prof_sidetone;
sidetone sidetone_inst( .clock(CLRCLK), .enable(sidetone), .tone_freq(tone_freq), .sidetone_level(sidetone_level), .CW_PTT(CW_PTT),
                        .prof_sidetone(prof_sidetone),  .profile(profile >>> 1));	// divide sidetone profile level by two since only 16 bits used
				
				
//-------------------------------------------------------
//		ADC control
//--------------------------------------------------------- 

reg [15:0]temp_ADC[0:1];
reg [15:0]temp_io_reg[0:1];
reg [15:0] temp_DACD; // for pre-distortion

always @ (posedge INA_CLK) 
begin 
	 temp_DACD <= {~DACD[13], DACD[12:0], 2'b00}; // make DACD 16-bits, use high bits for DACD
    temp_io_reg[0] <= {~INA[15], INA[14:0]};  
end 
 
always @ (posedge INA_CLK_2) 
    temp_io_reg[1] <= {~INA_2[15], INA_2[14:0]};  

always @(posedge C122_clk) 
begin
   temp_ADC[0] <= temp_io_reg[0];
	temp_ADC[1] <= temp_io_reg[1];
end
   
//------------------------------------------------------------------------------
//                 All DSP code is in the Receiver module
//------------------------------------------------------------------------------

wire      [31:0] C122_frequency_HZ [0:NR-1];   // frequency control bits for CORDIC
reg       [31:0] C122_frequency_HZ_Tx;
reg       [31:0] C122_last_freq [0:NR-1];
reg       [31:0] C122_last_freq_Tx;
reg       [31:0] C122_sync_phase_word [0:NR-1];
reg       [31:0] C122_sync_phase_word_Tx;
wire      [63:0] C122_ratio [0:NR-1];
wire      [63:0] C122_ratio_Tx;
wire      [23:0] rx_I [0:NR-1];
wire      [23:0] rx_Q [0:NR-1];
wire             strobe [0:NR-1];
wire      [15:0] C122_SampleRate[0:NR-1]; 
wire      [7:0] C122_RxADC[0:NR-1];
wire      [7:0] C122_SyncRx[0:NR-1];
wire      [31:0] C122_phase_word[0:NR-1]; 
wire      [15:0] select_input_RX[0:NR-1];		// set receiver module input sources


generate
genvar c;
  for (c = 0; c < NR; c = c + 1) 
   begin: MDC
	
	// Move RxADC[n] to C122 clock domain
	cdc_mcp #(16) ADC_select
	(.a_rst(C122_rst), .a_clk(rx_clock), .a_data(RxADC[c]), .a_data_rdy(Rx_data_ready), .b_rst(C122_rst), .b_clk(C122_clk), .b_data(C122_RxADC[c]));


	// Move Rx[n] sample rate to C122 clock domain
	cdc_mcp #(16) S_rate
	(.a_rst(C122_rst), .a_clk(rx_clock), .a_data(RxSampleRate[c]), .a_data_rdy(Rx_data_ready), .b_rst(C122_rst), .b_clk(C122_clk), .b_data(C122_SampleRate[c]));

	// move Rx phase words to C122 clock domain
	cdc_sync #(32) Rx_freqX
	(.siga(Rx_frequency[c]), .rstb(C122_rst), .clkb(C122_clk), .sigb(C122_frequency_HZ[c]));

	if (c > 1) 
	begin
	   receiver2 receiver_instX(   
	   //control
	   .reset(!C122_run),
	   .clock(C122_clk),
	   .sample_rate(C122_SampleRate[c]),
	   .frequency(C122_frequency_HZ[c]),     // PC send phase word now 32'd244667733
	   .out_strobe(strobe[c]),
	   //input
	   .in_data(select_input_RX[c]),
	   //output
	   .out_data_I(rx_I[c]),
	   .out_data_Q(rx_Q[c])
	   );
	end
  end
endgenerate

genvar e;
generate
for (e = 0; e < NR; e = e + 1) begin : rxloop
	always @(posedge C122_clk)
	begin
		if (e == 1) select_input_RX[e] = (C122_RxADC[e] == 8'd2) ? temp_DACD : (C122_RxADC[e] == 8'd1 ? temp_ADC[1] : temp_ADC[0]);
		else select_input_RX[e] = (C122_RxADC[e] == 8'd1) ? temp_ADC[1] : temp_ADC[0];
	end
end
endgenerate

	receiver2 receiver_inst0(   
	//control
	.reset(fifo_clear || !C122_run),
	.clock(C122_clk),
	.sample_rate(C122_SampleRate[0]),
	.frequency(C122_frequency_HZ[0]),     // PC send phase word now
	.out_strobe(strobe[0]),
	//input
	.in_data(select_input_RX[0]),
	//output
	.out_data_I(rx_I[0]),
	.out_data_Q(rx_Q[0])
	);

	receiver2 receiver_inst1(   
	//control
	.reset(fifo_clear || !C122_run),
	.clock(C122_clk),
	.sample_rate(C122_SampleRate[1]),
	.frequency(C122_frequency_HZ[1]),     // PC send phase word now
	.out_strobe(strobe[1]),
	//input
	.in_data(select_input_RX[1]),			  // to allow for both Diversity and PureSignal operations
	//output
	.out_data_I(rx_I[1]),
	.out_data_Q(rx_Q[1])
	);

// only using Rx0 and Rx1 Sync for now so can use simpler code
	// Move SyncRx[n] into C122 clock domain
	cdc_mcp #(8) SyncRx_inst
	(.a_rst(C122_rst), .a_clk(rx_clock), .a_data(SyncRx[0]), .a_data_rdy(Rx_data_ready), .b_rst(C122_rst), .b_clk(C122_clk), .b_data(C122_SyncRx[0]));
	
	

//---------------------------------------------------------
//                 Transmitter code 
//---------------------------------------------------------	

//---------------------------------------------------------
//  Interpolate by 640 CIC filter
//---------------------------------------------------------

//For interpolation, the growth in word size is  Celi(log2(R^(M-1))
//so for 5 stages and R = 640  = log2(640^4) = 37.28 so use 38

wire req1;
wire [16:0] y2_r, y2_i;

CicInterpM5 #(.RRRR(640), .IBITS(24), .OBITS(17), .GBITS(38)) in2 (C122_clk, 1'd1, req1, IQ_Tx_data[47:24],
					IQ_Tx_data[23:0], y2_r, y2_i); 

	
//------------------------------------------------------
//    CORDIC NCO 
//---------------------------------------------------------

// Code rotates input at set frequency and produces I & Q 


wire signed [21:0] C122_cordic_i_out; 
//wire signed [14:0] C122_cordic_i_out; 
wire signed [31:0] C122_phase_word_Tx;

wire signed [16:0] I;
wire signed [16:0] Q;

//  overall cordic gain is Sqrt(2)*1.647 = 2.33  
// if break_in is slected then CW_PTT can generate RF otherwise PC_PTT must be active.	
assign I =  (CW_PTT & break_in) ? CW_RF : ((CW_PTT & PC_PTT) ?  CW_RF : y2_i);   	// select CW mode if active. Set CORDIC for max DAC output
assign Q = CW_PTT ? 17'd0 : y2_r; 					// taking into account CORDICs gain i.e. 0x7FFF/1.7


// NOTE:  I and Q inputs reversed to give correct sideband out 

cpl_cordic # (.IN_WIDTH(17))
 		cordic_inst (.clock(_122MHz_in), .frequency(C122_frequency_HZ_Tx), .in_data_I(I), 
		.in_data_Q(Q), .out_data_I(C122_cordic_i_out), .out_data_Q());		
			 	 


// the CORDIC output is stable on the negative edge of the clock

always @ (negedge _122MHz_in)
	DACD <= {~C122_cordic_i_out[21], C122_cordic_i_out[20:8]};   
 

//------------------------------------------------------------
//  Set Power Output 
//------------------------------------------------------------

// PWM DAC to set drive current to DAC. PWM_count increments 
// using rx_clock. If the count is less than the drive 
// level set by the PC then DAC_ALC will be high, otherwise low.  

reg [7:0] PWM_count;
always @ (posedge rx_clock)
begin 
	PWM_count <= PWM_count + 1'b1;
	if (Drive_Level >= PWM_count)
		DAC_ALC <= 1'b1;
	else 
		DAC_ALC <= 1'b0;
end 


//---------------------------------------------------------
//              Decode Command & Control data
//---------------------------------------------------------

wire         mode;     			// normal or Class E PA operation 
wire         Attenuator;		// selects input attenuator setting, 1 = 20dB, 0 = 0dB 
wire  [31:0] frequency[0:NR-1]; 	// Tx, Rx1, Rx2, Rx3, Rx4, Rx5, Rx6, Rx7
wire         IF_duplex;
wire   [7:0] Drive_Level; 		// Tx drive level
wire         Mic_boost;			// Mic boost 0 = 0dB, 1 = 20dB
wire         Line_In;				// Selects input, mic = 0, line = 1
wire			 common_Merc_freq;		// when set forces Rx2 freq to Rx1 freq
wire   [4:0] Line_In_Gain;		// Sets Line-In Gain value (00000=-32.4 dB to 11111=+12 dB in 1.5 dB steps)
wire         Apollo;				// Selects Alex (0) or Apollo (1)
wire   [4:0] Attenuator0;			// 0-31 dB Heremes attenuator value
wire			 TR_relay_disable;		// Alex T/R relay disable option
wire	 [4:0] Attenuator1;		// attenuation setting for input attenuator 2 (input atten for ADC2), 0-31 dB
wire         internal_CW;			// set when internal CW generation selected
wire   [7:0] sidetone_level;		// 0 - 100, sets internal sidetone level
wire 			 sidetone;				// Sidetone enable, 0 = off, 1 = on
wire   [7:0] RF_delay;				// 0 - 255, sets delay in mS from CW Key activation to RF out
wire   [9:0] hang;					// 0 - 1000, sets delay in mS from release of CW Key to dropping of PTT
wire  [11:0] tone_freq;				// 200 to 1000 Hz, sets sidetone frequency.
wire         key_reverse;		   // reverse CW keyes if set
wire   [5:0] keyer_speed; 			// CW keyer speed 0-60 WPM
wire         keyer_mode;			// 0 = Mode A, 1 = Mode B
wire 			 iambic;					// 0 = external/straight/bug  1 = iambic
wire   [7:0] keyer_weight;			// keyer weight 33-66
wire         keyer_spacing;		// 0 = off, 1 = on
wire 			 break_in;				// if set then use break in mode
wire   [4:0] atten0_on_Tx;			// ADC0 attenuation value to use when Tx is active
wire   [4:0] atten1_on_Tx;			// ADC1 attenuation value to use when Tx is active
wire  [31:0] Rx_frequency[0:NR-1];	// Rx(n) receive frequency
wire  [31:0] Tx0_frequency;		// Tx0 transmit frequency
wire  [31:0] Alex_data;				// control data to Alex board
wire         run;						// set when run active 
wire 		    PC_PTT;					// set when PTT from PC active
wire 	 [7:0] dither;					// Dither for ADC0[0], ADC1[1]...etc
wire   [7:0] random;					// Random for ADC0[0], ADC1[1]...etc
wire   [7:0] RxADC[0:NR-1];			// ADC or DAC that Rx(n) is connected to
wire 	[15:0] RxSampleRate[0:NR-1];	// Rxn Sample rate 48/96/192 etc
wire 			 Alex_data_ready;		// indicates Alex data available
wire         Rx_data_ready;		// indicates Rx_specific data available
wire 			 Tx_data_ready;		// indicated Tx_specific data available
wire   [7:0] Mux;						// Rx in mux mode when bit set, [0] = Rx0, [1] = Rx1 etc 
wire   [7:0] SyncRx[0:NR-1];			// bit set selects Rx to sync or mux with
wire 	 [7:0] EnableRx0_7;			// Rx enabled when bit set, [0] = Rx0, [1] = Rx1 etc
wire 	 [7:0] C122_EnableRx0_7;
wire  [15:0] Rx_Specific_port;	// 
wire  [15:0] Tx_Specific_port;
wire  [15:0] High_Prioirty_from_PC_port;
wire  [15:0] High_Prioirty_to_PC_port;			
wire  [15:0] Rx_Audio_port;
wire  [15:0] Tx_IQ_port;
wire  [15:0] Rx0_port;
wire  [15:0] Mic_port;
wire  [15:0] Wideband_ADC0_port;
wire   [7:0] Wideband_enable;					// [0] set enables ADC0, [1] set enables ADC1
wire  [15:0] Wideband_samples_per_packet;				
wire   [7:0] Wideband_sample_size;
wire   [7:0] Wideband_update_rate;
wire   [7:0] Wideband_packets_per_frame; 
wire  [15:0] Envelope_PWM_max;
wire  [15:0] Envelope_PWM_min;
wire   [7:0] Open_Collector;
wire   [7:0] User_Outputs;
wire   [7:0] Mercury_Attenuator;	
wire 			 CWX;						// CW keyboard from PC 
wire         Dot;						// CW dot key from PC
wire         Dash;					// CW dash key from PC]
wire freq_data_ready;



//wire   [7:0] Atlas_bus;
//wire     [7:0] _10MHz_reference,
wire         PA_enable;
//wire         Apollo_enable;	
wire   [7:0] Alex_enable;			
wire         data_ready;
wire 			 HW_reset1;
wire 			 HW_reset2;	
wire 			 HW_reset3;
wire 			 HW_reset4;
wire 			 HW_timer_enable;

General_CC #(1024) General_CC_inst // parameter is port number  ***** this data is in rx_clock domain *****
			(
				// inputs
				.clock(rx_clock),
				.to_port(to_port),
				.udp_rx_active(udp_rx_active),
				.udp_rx_data(udp_rx_data),
				// outputs
			   .Rx_Specific_port(Rx_Specific_port),
				.Tx_Specific_port(Tx_Specific_port),
				.High_Prioirty_from_PC_port(High_Prioirty_from_PC_port),
				.High_Prioirty_to_PC_port(High_Prioirty_to_PC_port),			
				.Rx_Audio_port(Rx_Audio_port),
				.Tx_IQ_port(Tx_IQ_port),
				.Rx0_port(Rx0_port),
				.Mic_port(Mic_port),
				.Wideband_ADC0_port(Wideband_ADC0_port),
				.Wideband_enable(Wideband_enable),
				.Wideband_samples_per_packet(Wideband_samples_per_packet),				
				.Wideband_sample_size(Wideband_sample_size),
				.Wideband_update_rate(Wideband_update_rate),
				.Wideband_packets_per_frame(Wideband_packets_per_frame),
				.PA_enable(PA_enable),
				.Apollo_enable(TUNE),	
				.Alex_enable(Alex_enable),			
				.data_ready(data_ready),
				.HW_reset(HW_reset1),
				.HW_timer_enable(HW_timer_enable)
				);



High_Priority_CC #(1027, NR) High_Priority_CC_inst  // parameter is port number 1027  ***** this data is in rx_clock domain *****
			(
				// inputs
				.clock(rx_clock),
				.to_port(to_port),
				.udp_rx_active(udp_rx_active),
				.udp_rx_data(udp_rx_data),
				.HW_timeout(HW_timeout),					// used to clear run if HW timeout.
				// outputs
			   .run(run),
				.PC_PTT(PC_PTT),
				.CWX(CWX),
				.Dot(Dot),
				.Dash(Dash),
				.Rx_frequency(Rx_frequency),
				.Tx0_frequency(Tx0_frequency),
				.Alex_data(Alex_data),
				.drive_level(Drive_Level),
				.Attenuator0(Attenuator0),
				.Attenuator1(Attenuator1),
				.Open_Collector(Open_Collector),			// open collector outputs on Angelia
			//	.User_Outputs(),
			//	.Mercury_Attenuator(),	
				.Alex_data_ready(Alex_data_ready),
				.HW_reset(HW_reset2)
			);

// if break_in is selected then CW_PTT can activate the PTT_out. 
// if break_in is slected then CW_PTT can generate RF otherwise PC_PTT must be active.	
// inhibit T/R switching if IO4 TX INHIBIT is active (low)		
assign PTT_out = run && ((break_in && CW_PTT) || PC_PTT || debounce_PTT); // CW_PTT is used when internal CW is selected

// clear TR relay and Open Collectors if run not set 
wire [31:0]runsafe_Alex_data 		  = {Alex_data[31:28], run ? (PTT_out | Alex_data[27]) : 1'b0, Alex_data[26:0]};




Tx_specific_CC #(1026)Tx_specific_CC_inst //   // parameter is port number  ***** this data is in rx_clock domain *****
			( 	
				// inputs
				.clock (rx_clock),
				.to_port (to_port),
				.udp_rx_active (udp_rx_active),
				.udp_rx_data (udp_rx_data),
				// outputs
				.EER() ,
				.internal_CW (internal_CW),
				.key_reverse (key_reverse), 
				.iambic (iambic),					
				.sidetone (sidetone), 			
				.keyer_mode (keyer_mode), 		
				.keyer_spacing(keyer_spacing),
				.break_in(break_in), 						
				.sidetone_level(sidetone_level), 
				.tone_freq(tone_freq), 
				.keyer_speed(keyer_speed),	
				.keyer_weight(keyer_weight),
				.hang(hang), 
				.RF_delay(RF_delay),
				.Line_In(Line_In),
				.Line_In_Gain(Line_In_Gain),
				.Mic_boost(Mic_boost),
				.Angelia_atten_Tx1(atten1_on_Tx),
				.Angelia_atten_Tx0(atten0_on_Tx),
			   .data_ready(Tx_data_ready),
				.HW_reset(HW_reset3)	

			);

			
Rx_specific_CC #(1025, NR) Rx_specific_CC_inst // parameter is port number 
			( 	
				// inputs
				.clock(rx_clock),
				.to_port(to_port),
				.udp_rx_active(udp_rx_active),
				.udp_rx_data(udp_rx_data),
				// outputs
				.dither(dither),
				.random(random),
				.RxSampleRate(RxSampleRate),
				.RxADC(RxADC),	
				.SyncRx(SyncRx),
				.EnableRx0_7(EnableRx0_7),
				.Rx_data_ready(Rx_data_ready),
				.Mux(Mux),
				.HW_reset(HW_reset4)
			);			
			
assign  RAND   = random[0];        		//high turns random on
assign  DITH   = dither[0];      		//high turns LTC2208 dither on  		

// transfer C&C data in rx_clock domain, on strobe, into relevant clock domains
cdc_mcp #(32) Tx1_freq 
 (.a_rst(C122_rst), .a_clk(rx_clock), .a_data(Tx0_frequency), .a_data_rdy(Alex_data_ready), .b_rst(C122_rst), .b_clk(C122_clk), .b_data(C122_frequency_HZ_Tx));
 
// move Mux data into C122_clk domain
wire [7:0]C122_Mux;
cdc_mcp #(8) Mux_inst 
	(.a_rst(C122_rst), .a_clk(rx_clock), .a_data(Mux), .a_data_rdy(Rx_data_ready), .b_rst(C122_rst), .b_clk(C122_clk), .b_data(C122_Mux)); 

// move Alex data into CBCLK domain
wire  [31:0] SPI_Alex_data;
cdc_sync #(32) SPI_Alex (.siga(runsafe_Alex_data), .rstb(IF_rst), .clkb(CBCLK), .sigb(SPI_Alex_data));
 

 
//------------------------------------------------------------
//  			High Priority to PC C&C Encoder 
//------------------------------------------------------------

// All input data is transfered to tx_clock domain in the encoder

wire CC_ack;
wire CC_data_ready;
wire [7:0] CC_data[0:55];
wire [15:0] Exciter_power = PTT_out ? {4'b0,AIN5} : 16'b0; 
wire [15:0] FWD_power     = {4'b0,AIN1};
wire [15:0] REV_power     = {4'b0,AIN2};
wire [15:0] user_analog1  = {4'b0, AIN3}; 
wire [15:0] user_analog2  = {4'b0, AIN4}; 
 
CC_encoder #(50, NR) CC_encoder_inst (				// 50mS update rate
					//	inputs
					.clock(tx_clock),					// tx_clock  125MHz
					.ACK (CC_ack),
					.PTT ((break_in & CW_PTT) | debounce_PTT),
					.Dot (debounce_DOT),
					.Dash(debounce_DASH),
					//.frequency_change(),
					.locked_10MHz(locked_10MHz),		// set if the 10MHz divider PLL is locked.
					.ADC0_overload (OVERFLOW),
					.ADC1_overload (OVERFLOW_2),
					.Exciter_power (Exciter_power),			
					.FWD_power (FWD_power),
					.REV_power (REV_power),
					.Supply_volts ({4'b0,AIN6}),  
					.User_ADC1 (user_analog1),
					.User_ADC2 (user_analog2),
					.User_IO ({8'b0}),
					.Debug_data(16'd0),
					.FPGA_PTT(PTT_out),						// when set change update rate to 1mS
							
					//	outputs
					.CC_data (CC_data),
					.ready (CC_data_ready)
				);
							
 
 
 
 
//------------------------------------------------------------
//  On-board attenuator 
//------------------------------------------------------------

// set the two input attenuators
wire [4:0] atten0;
wire [4:0] atten1;

assign atten0 = PTT_out ? atten0_on_Tx : Attenuator0;
assign atten1 = PTT_out ? atten1_on_Tx : Attenuator1; 

Attenuator atten (.clk(CMCLK), .att(atten0), .att_2(atten1), .ATTN_CLK(ATTN_CLK), .ATTN_DATA(ATTN_DATA), .ATTN_LE(ATTN_LE), .ATTN_LE_2(ATTN_LE_2));


//---------------------------------------------------------
//  Debounce inputs - active low
//---------------------------------------------------------

wire debounce_PTT;    // debounced button
wire debounce_DOT;
wire debounce_DASH;

debounce de_PTT	(.clean_pb(debounce_PTT),  .pb(!PTT_in | !PTT_in_UO), .clk(CMCLK));
debounce de_DOT	(.clean_pb(debounce_DOT),  .pb(!KEY_DOT),  .clk(CMCLK));
debounce de_DASH	(.clean_pb(debounce_DASH), .pb(!KEY_DASH), .clk(CMCLK));


//-----------------------------------------------------------
//  LED Control  
//-----------------------------------------------------------

/*
	LEDs:  
	
	DEBUG_LED1  	- Lights when an Ethernet broadcast is detected
	DEBUG_LED2  	- Lights when traffic to the boards MAC address is detected
	DEBUG_LED3  	- Lights when detect a received sequence error or ASMI is busy
	DEBUG_LED4 		- Displays state of PHY negotiations - fast flash if no Ethernet connection, slow flash if 100T and on if 1000T
	DEBUG_LED5		- Lights when the PHY receives Ethernet traffic
	DEBUG_LED6  	- Lights when the PHY transmits Ethernet traffic
	DEBUG_LED7  	- Displays state of DHCP negotiations or static IP - on if ACK, slow flash if NAK, fast flash if time out 
					     and long then short flash if static IP
	DEBUG_LED8  	- Lights when sync (0x7F7F7F) received from PC
	DEBUG_LED9  	- Lights when a Metis discovery packet is received
	DEBUG_LED10 	- Lights when a Metis discovery packet reply is sent	
	
	Status_LED	    - Flashes once per second
	
	A LED is flashed for the selected period on the positive edge of the signal.
	If the signal period is greater than the LED period the LED will remain on.


*/

parameter half_second = 2_500_000; // at 12.288MHz clock rate
parameter dimmer = 3;  // LED bright 0 - 255

reg [7:0] dim_cnt = 0;
always @(posedge CMCLK)  if (dim_cnt != 255) dim_cnt <= dim_cnt + 1'd1; else dim_cnt <= 0;

wire Status_LED; 
wire DEBUG_LED1;             
wire DEBUG_LED2;
wire DEBUG_LED3;
wire DEBUG_LED4;
wire DEBUG_LED5;
wire DEBUG_LED6;
wire DEBUG_LED7;
wire DEBUG_LED8;
wire DEBUG_LED9;
wire DEBUG_LED10;

assign led1 = Status_LED & (dim_cnt <= dimmer);  // Heart Beat
assign led2 = DEBUG_LED5 & (dim_cnt <= dimmer);  // connection's status
assign led3 = DEBUG_LED1 & (dim_cnt <= dimmer);  // receive from PHY
assign led4 = DEBUG_LED2 & (dim_cnt <= dimmer);  // transmitt to PHY



// flash LED1 for ~ 0.2 second whenever rgmii_rx_active
Led_flash Flash_LED1(.clock(CMCLK), .signal(network_status[2]), .LED(DEBUG_LED1), .period(half_second)); 

// flash LED2 for ~ 0.2 second whenever the PHY transmits
Led_flash Flash_LED2(.clock(CMCLK), .signal(network_status[1]), .LED(DEBUG_LED2), .period(half_second)); 
//assign RAM_A2 = 1'b1; // turn the LED off for now. 	

// flash LED3 for ~0.2 seconds whenever ip_rx_enable
//Led_flash Flash_LED3(.clock(CMCLK), .signal(network_status[1]), .LED(DEBUG_LED3), .period(half_second));
// flash LED4 for ~0.2 seconds whenever traffic to the boards MAC address is received 
//Led_flash Flash_LED4(.clock(CMCLK), .signal(network_status[0]), .LED(DEBUG_LED4), .period(half_second));

// flash LED5 for ~0.2 seconds whenever udp_rx_enable
// Led_flash Flash_LED5(.clock(CMCLK), .signal(network_status[3]), .LED(DEBUG_LED5), .period(half_second));

// LED6 = on if ACK, slow flash if NAK, fast flash if time out and swap between fast and slow 
// if using a static IP address
// flash LED7 for ~0.2 seconds whenever udp_rx_active
//Led_flash Flash_LED7(.clock(CMCLK), .signal(network_status[4]), .LED(DEBUG_LED7), .period(half_second));

// flash LED8 for ~0.2 seconds whenever we detect a Metis discovery request
//Led_flash Flash_LED8(.clock(CMCLK), .signal(discovery_reply), .LED(DEBUG_LED8), .period(half_second));

// flash LED9 for ~0.2 seconds whenever we respond to a Metis discovery request
//Led_flash Flash_LED9(.clock(CMCLK), .signal(discovery_respond), .LED(DEBUG_LED9), .period(half_second));   // Rx_Audio_fifo_wrreq

// flash LED9 for ~0.2 seconds when
//Led_flash Flash_LED9(.clock(CMCLK), .signal(Audio_empty & run & get_audio_samples), .LED(DEBUG_LED9), .period(half_second)); 

// flash LED10 for ~0.2 seconds when 
//Led_flash Flash_LED10(.clock(CMCLK), .signal(Audio_full & run), .LED(DEBUG_LED10), .period(half_second));  


//  Overflow forming
wire OVF, OVF_2;

Led_flash overflow_form  (.clock(CMCLK), .signal(OVERFLOW),   .LED(OVF),   .period(6_000_000));
Led_flash overflow_form_2(.clock(CMCLK), .signal(OVERFLOW_2), .LED(OVF_2), .period(6_000_000));

//Flash Heart beat LED
reg [26:0]HB_counter;
always @(posedge PHY_CLK125) HB_counter = HB_counter + 1'b1;

assign Status_LED = (HB_counter[25] & dim_cnt <= dimmer);  // Blink


//------------------------------------------------------------
//   Multi-state LED Control   - code in Led_control is for active LOW LEDs
//------------------------------------------------------------

parameter clock_speed = 12_288_000; // 12.288MHz clock 

// display state of PHY negotiations  - fast flash if no Ethernet connection, slow flash if 100T, on if 1000T
// and swap between fast and slow flash if not full duplex
Led_control #(clock_speed) Control_LED0(.clock(CMCLK), .on(network_status[6]), .fast_flash(~network_status[5] & ~network_status[6]),
										.slow_flash(network_status[5]), .vary(1'b0), .LED(DEBUG_LED5));  
//										
//// display state of DHCP negotiations - on if success, slow flash if fail, fast flash if time out and swap between fast and slow 
//// if using a static IP address
//Led_control # (clock_speed) Control_LED1(.clock(CMCLK), .on(dhcp_success), .slow_flash(dhcp_failed & !dhcp_timeout),
//										.fast_flash(dhcp_timeout), .vary(static_ip_assigned), .LED(DEBUG_LED6));	

endmodule 
