Dfinitski/Odyssey_3_2015/Odyssey_3_2.0_ANP/Sources/Ethernet/mac_recv.v

//
//  HPSDR - High Performance Software Defined Radio
//
//  Metis code. 
//
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

//  Metis code copyright 2010, 2011, 2012, 2013 Alex Shovkoplyas, VE3NEA.


//-----------------------------------------------------------------------------
// receive ethernet header; check destination mac address and discard packet
// if it is not for us; extract source mac address and packet type
//-----------------------------------------------------------------------------

module mac_recv(
  //input data stream
  input clock, 
  input rx_enable,
  input [7:0] data,

  //constant input parameter
  input [47:0] local_mac,

  //output
  output active,
  output reg broadcast,
  output reg is_arp,
  output reg [47:0] remote_mac
  );

  

  


//-----------------------------------------------------------------------------
//                            state machine
//-----------------------------------------------------------------------------
localparam ST_DST_ADDR = 3'd0, ST_SRC_ADDR = 3'd1, ST_PROTO = 3'd2, ST_PAYLOAD = 3'd3, ST_ERROR = 3'd4;
reg[2:0] state = ST_DST_ADDR;

reg [2:0] byte_no;
reg unicast;
reg [47:0] temp_remote_mac;

localparam HI_MAC_BYTE = 3'd5, HI_PROTO_BYTE = 3'd1;
parameter PROMISC = 1'b1;
localparam false = 1'b0, true = 1'b1;

assign active = rx_enable & (state == ST_PAYLOAD);


always @(posedge clock)
  if (rx_enable)
    case (state)
      ST_DST_ADDR:
        begin
        //is broadcast addr
        if (data != 8'hFF) broadcast <= false;
        //is local mac addr
        if (data != local_mac[byte_no*8+7 -: 8]) unicast <= false; 
        //continue
        if (byte_no != 0) byte_no <= byte_no - 3'd1; 
        //dst addr done
        else begin byte_no <= HI_MAC_BYTE; state <= ST_SRC_ADDR; end
        end
        
      ST_SRC_ADDR:
        begin        
			  //save remote mac
			  temp_remote_mac <= {temp_remote_mac[39:0], data};
			  if (byte_no != 0) byte_no <= byte_no - 3'd1;
			  //good destination mac, protocol id follows
			  // 2026: unicast frames are accepted for any destination MAC; the IP
			  // layers (udp_recv/icmp/arp) filter by our IP. The board MAC is random
			  // at every start, so a stale ARP entry on the PC no longer blocks it.
			  else if (broadcast | unicast | PROMISC) begin byte_no <= HI_PROTO_BYTE; state <= ST_PROTO; end
			  //bad destination mac, discard message
			  else state <= ST_ERROR;        
        end
        
      ST_PROTO:
			begin 
			  //protocol 0806 = arp, 0800 = ip
			  if (byte_no != 0) 
				 if (data != 8'h08) state <= ST_ERROR; 
				 else byte_no <= byte_no - 3'd1;
			  else if (data == 8'h06) begin
			  	 is_arp <= true; 
				 remote_mac <= temp_remote_mac;  // only update mac if protocol valid
				 state <= ST_PAYLOAD;
			  end
			  else if (data == 8'h00) begin
			  	 is_arp <= false;
				 remote_mac <= temp_remote_mac;  // only update mac if protocol vaild
				 state <= ST_PAYLOAD;
			  end
			  else state <= ST_ERROR;
		  end
      endcase
      
  else //!rx_enable 
    begin
    broadcast <= true;
    unicast <= true;
    byte_no <= HI_MAC_BYTE;
    state <= ST_DST_ADDR;
    end
    
  
  
endmodule
  
