Dfinitski/Odyssey_3_2015/Odyssey_3_2.0_ANP/Sources/Ethernet/udp_send.v

//
//  HPSDR - High Performance Software Defined Radio
//
//  Metis code. 
//
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

//  Metis code copyright 2010, 2011, 2012, 2013 Phil Harman VK6APH, Alex Shovkoplyas, VE3NEA.


module udp_send (
  input reset,
  input clock,
  input tx_enable,
  input [7:0] data_in,
  input [15:0] length_in,
  input [15:0] local_port,
  input [15:0] destination_port,
  input [7:0] port_ID,				// determines offset from port base address of 1024
 // input [47:0] remote_mac,
 // input [31:0] remote_ip,
  output active,
  output [7:0] data_out,
  output [15:0] length_out
 // output reg [47:0] destination_mac,
//  output reg [31:0] destination_ip
  );
  

//udp header
localparam HDR_LEN = 16'd8;
localparam HI_BIT = HDR_LEN * 8 - 1;
// 2026: header fields registered (inputs are stable for several cycles
// before tx_enable, see TX_SETUP in network.v) - breaks the long path
// mux -> length -> IP checksum
reg [15:0] length_r = 16'd0;
reg [15:0] src_port_r = 16'd0;
reg [15:0] dst_port_r = 16'd0;
always @(posedge clock) begin
  length_r   <= HDR_LEN + length_in;
  src_port_r <= local_port + {8'd0, port_ID};
  dst_port_r <= destination_port;
end
assign length_out = length_r;
wire [15:0] checksum = 16'b0;						// no checksum needed with IP4
wire [HI_BIT:0] tx_bits = {src_port_r, dst_port_r, length_out, checksum};

//shift reg
reg [HI_BIT:0] shift_reg;
assign data_out = shift_reg[HI_BIT -: 8];
reg [15:0] byte_no = 16'd0;   // power-up value as in hardware

//state machine
localparam false = 1'b0, true = 1'b1;
reg sending = false;
 
always @(posedge clock)  
  begin
  //tx data
  if (active) begin
	//	destination_mac <= remote_mac;
	//	destination_ip  <= remote_ip;
		shift_reg <= {shift_reg[HI_BIT-8:0], data_in};
  end 
  else shift_reg <= tx_bits;	  
  //send while payload is coming
  if (tx_enable) begin byte_no <= length_out -16'd1; sending <= true; end
  //purge shift register
  else if (byte_no != 0) byte_no <= byte_no - 15'd1;
  //done
  else sending <= false;
  end

  
assign active = (tx_enable | sending) && (byte_no != 0) ;  //last term prevents one too many bytes being sent
 
  
  
endmodule
  
